tuanito/2-wheel-balanced-bot/site/files/descend_step-100-fail.jpg

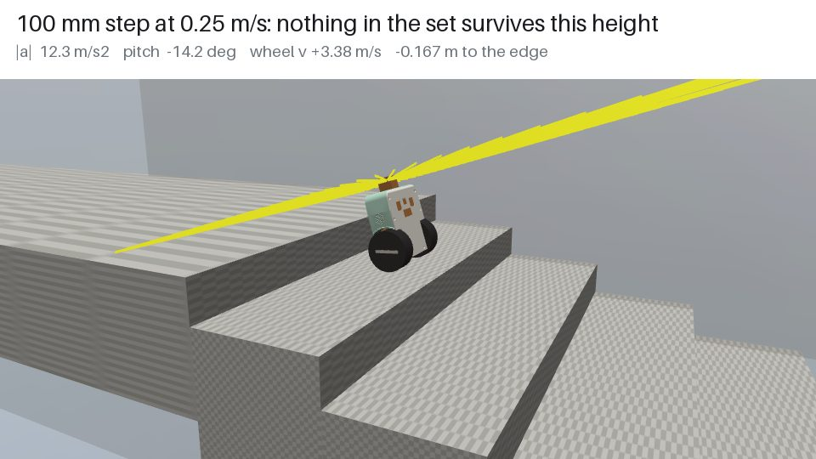
site/files/descend_step-100-fail.jpg
