tuanito/2-wheel-balanced-bot/site/files/descend_step-060-ok.jpg

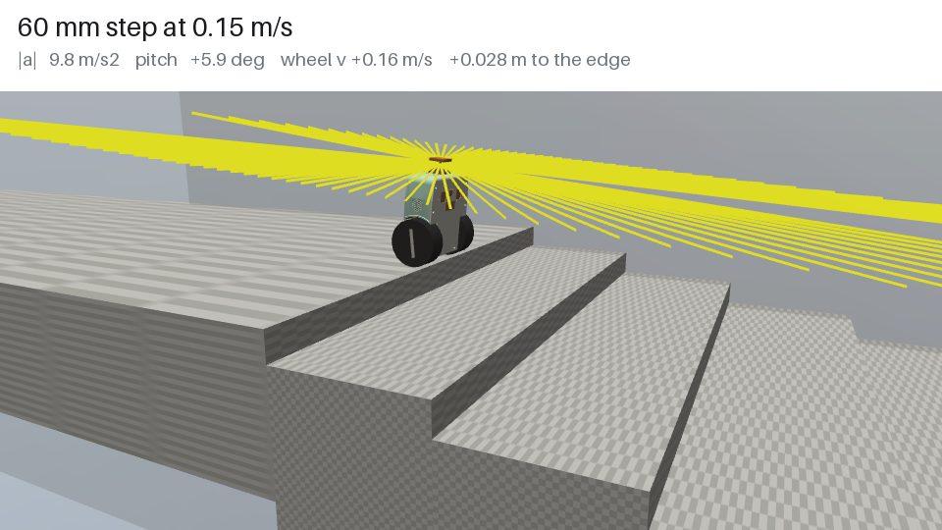
site/files/descend_step-060-ok.jpg
