tuanito/2-wheel-balanced-bot/site/files/descend_catch-100.jpg

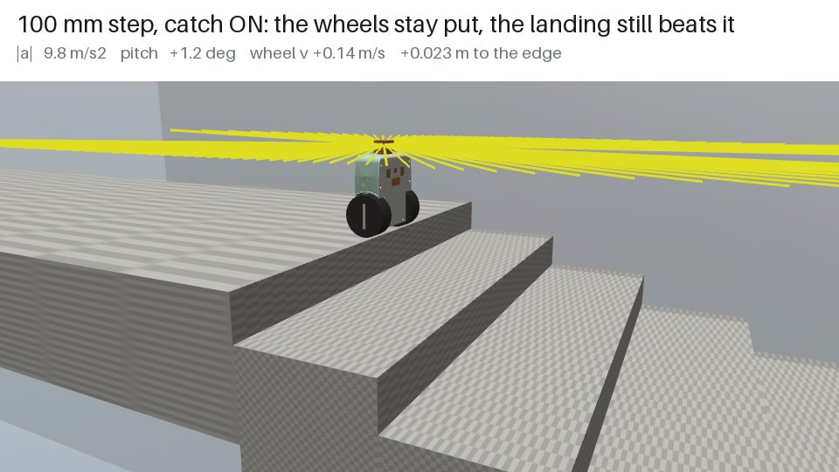
site/files/descend_catch-100.jpg
