tuanito/2-wheel-balanced-bot/site/files/descend_nocatch-040.jpg

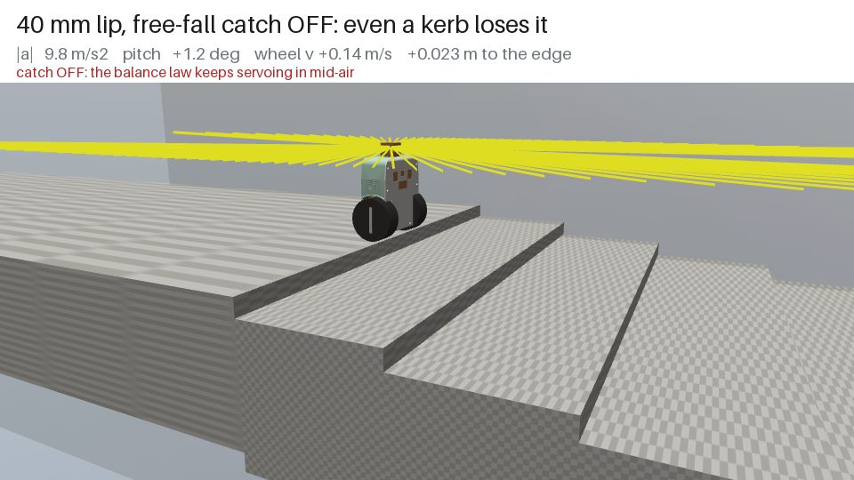
site/files/descend_nocatch-040.jpg
