tuanito/2-wheel-balanced-bot/site/files/descend_nocatch-100.jpg

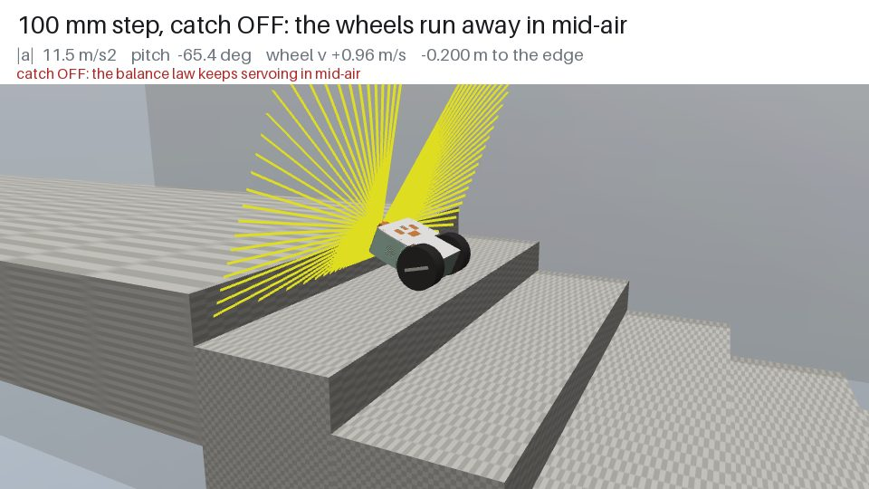
site/files/descend_nocatch-100.jpg
