tuanito/2-wheel-balanced-bot/site/files/flight_flight-060.jpg

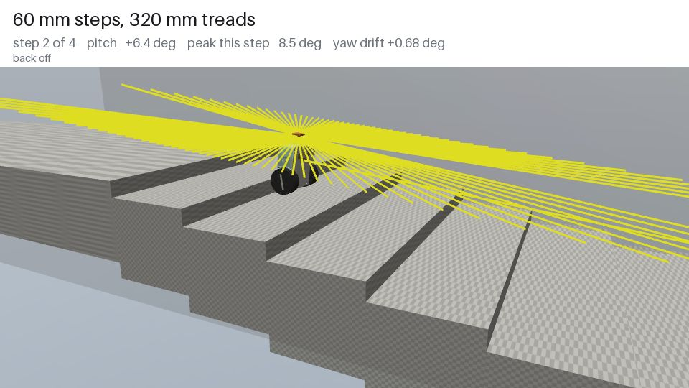
site/files/flight_flight-060.jpg
