tuanito/2-wheel-balanced-bot/site/files/flight_flight-150.jpg

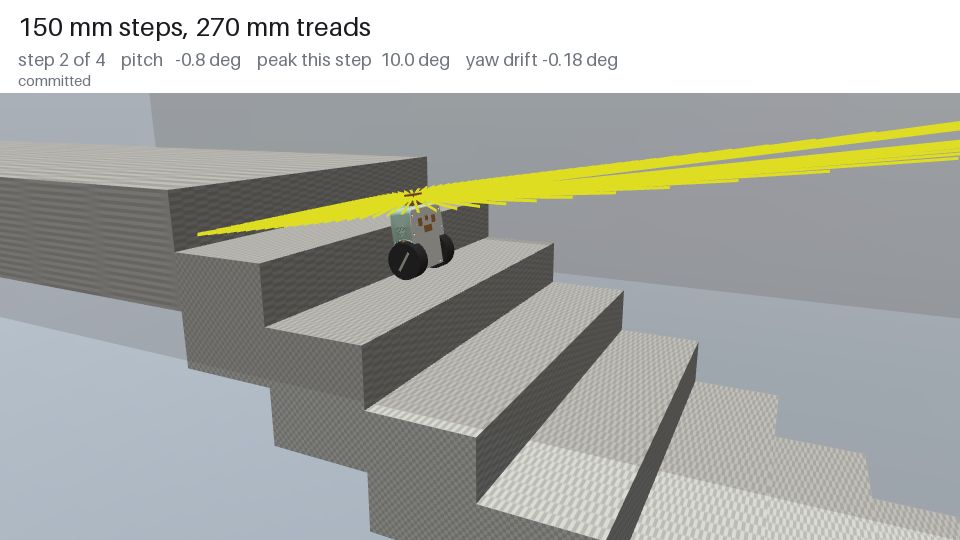
site/files/flight_flight-150.jpg
