tuanito/2-wheel-balanced-bot/site/files/flight_flight-170.jpg

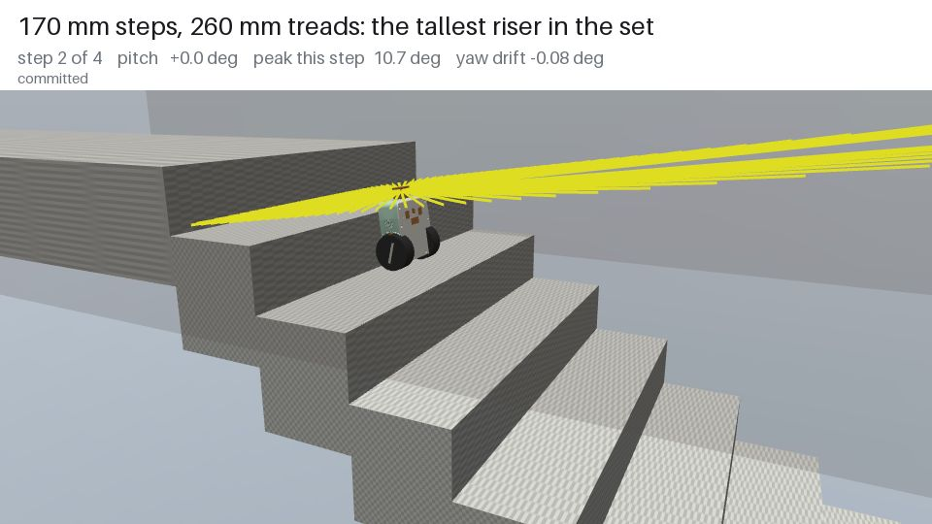
site/files/flight_flight-170.jpg
