tuanito/2-wheel-balanced-bot/site/files/stairs_ab00.jpg

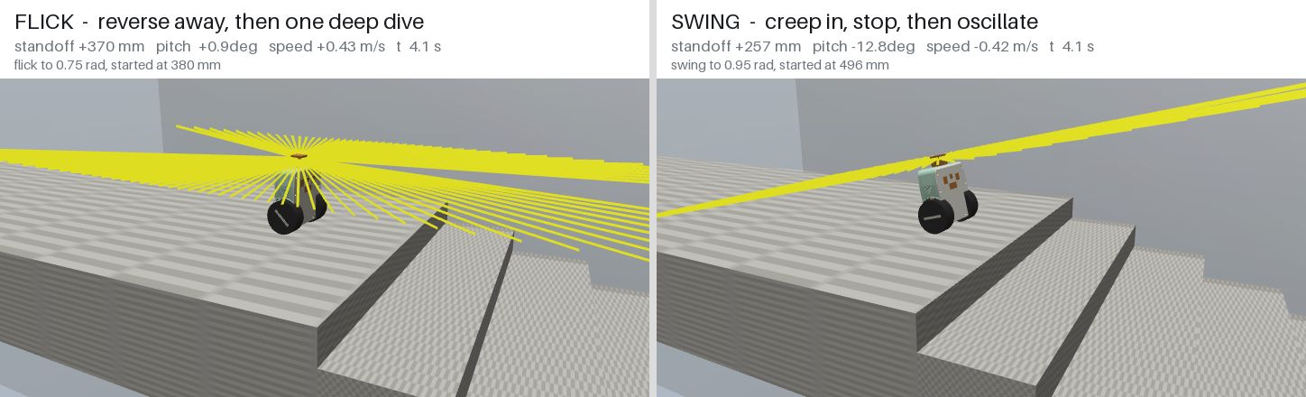
site/files/stairs_ab00.jpg
