tuanito/2-wheel-balanced-bot/site/files/stairs_ab01.jpg

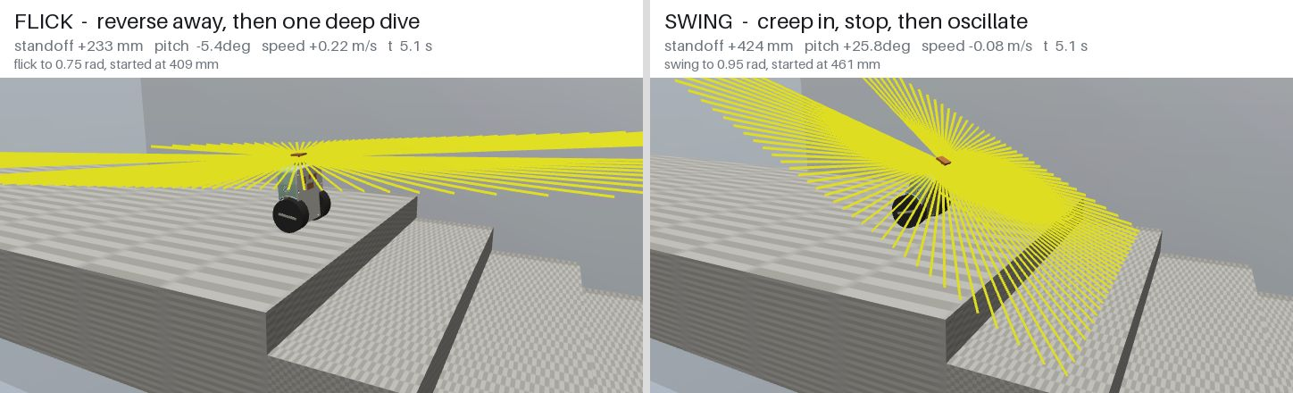
site/files/stairs_ab01.jpg
