tuanito/2-wheel-balanced-bot/site/files/stairs_ab02.jpg

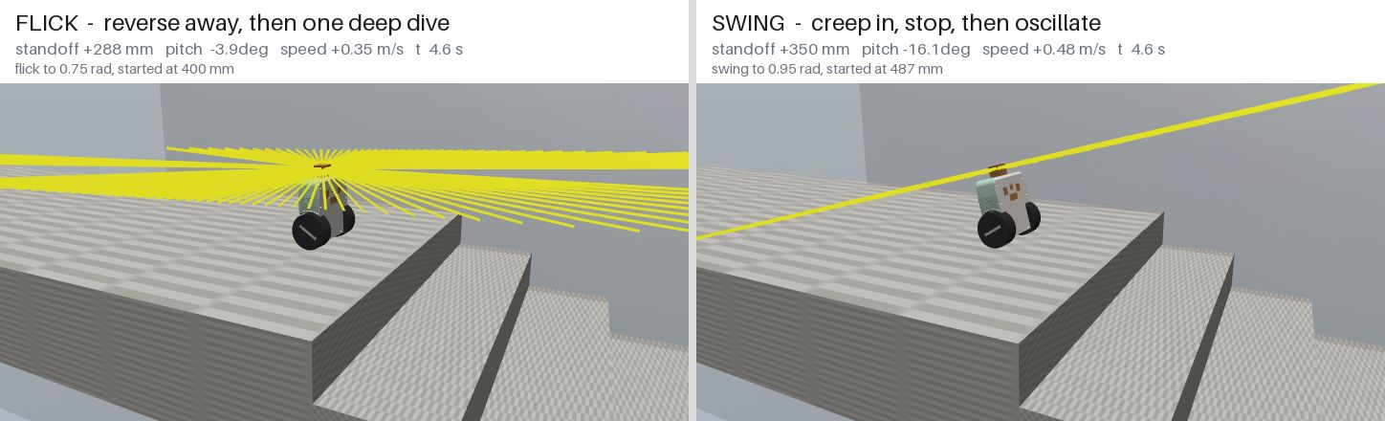
site/files/stairs_ab02.jpg
