tuanito/2-wheel-balanced-bot/site/files/stairs_ab04.jpg

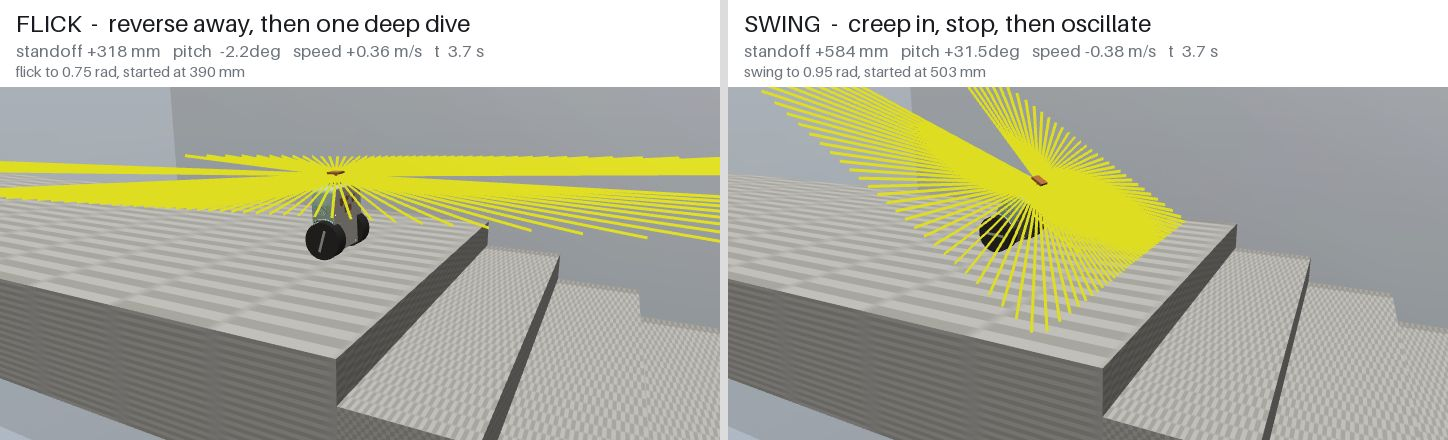
site/files/stairs_ab04.jpg
