tuanito/2-wheel-balanced-bot/site/files/stairs_ab05.jpg

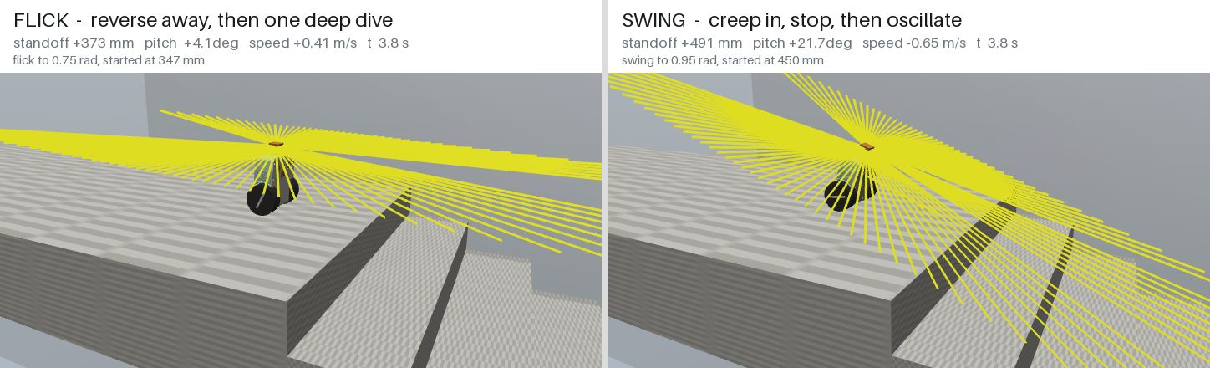
site/files/stairs_ab05.jpg
