tuanito/2-wheel-balanced-bot/site/files/stairs_ab06.jpg

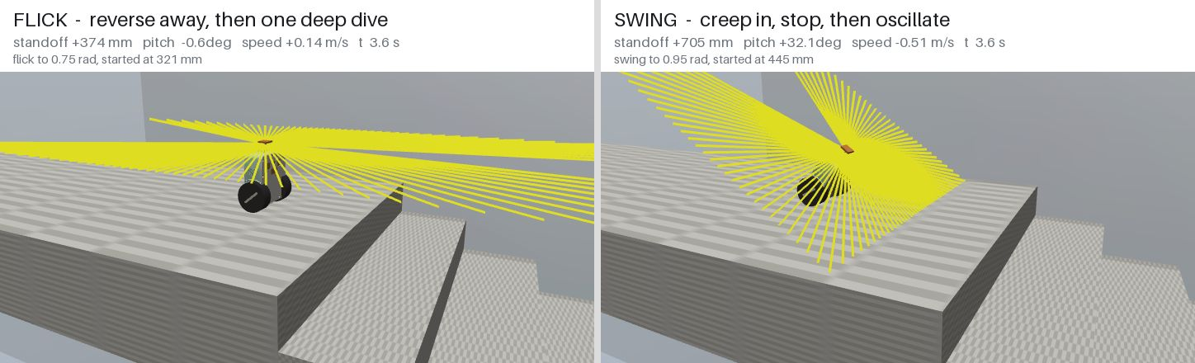
site/files/stairs_ab06.jpg
