tuanito/2-wheel-balanced-bot/site/files/stairs_ab07.jpg

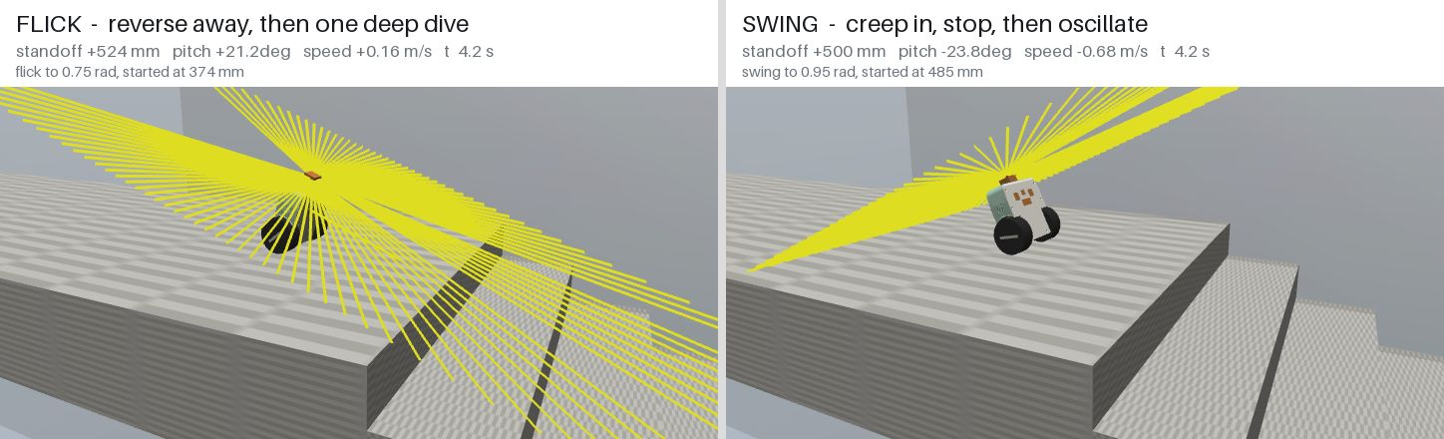
site/files/stairs_ab07.jpg
