tuanito/2-wheel-balanced-bot/site/files/stairs_ab08.jpg

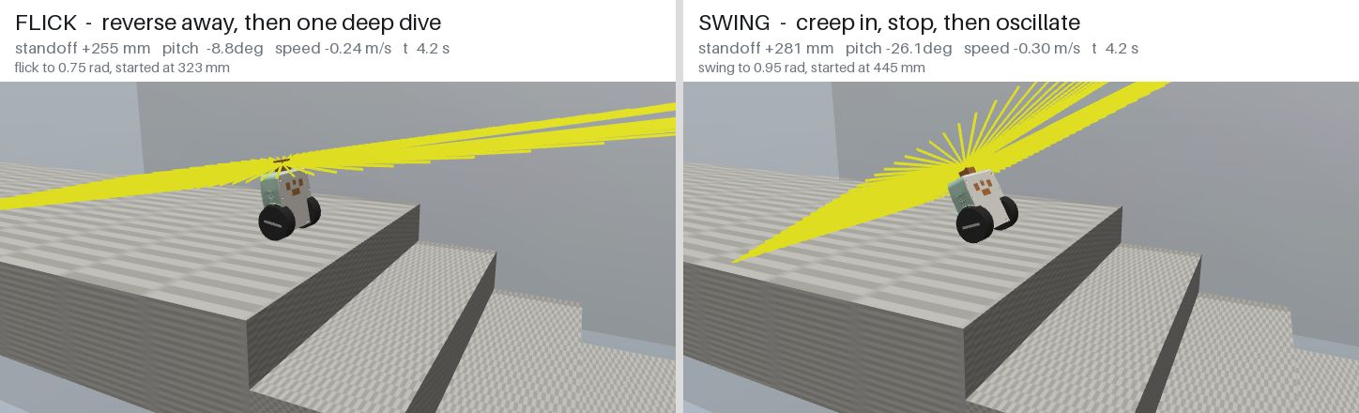
site/files/stairs_ab08.jpg
