tuanito/2-wheel-balanced-bot/site/files/stairs_ab09.jpg

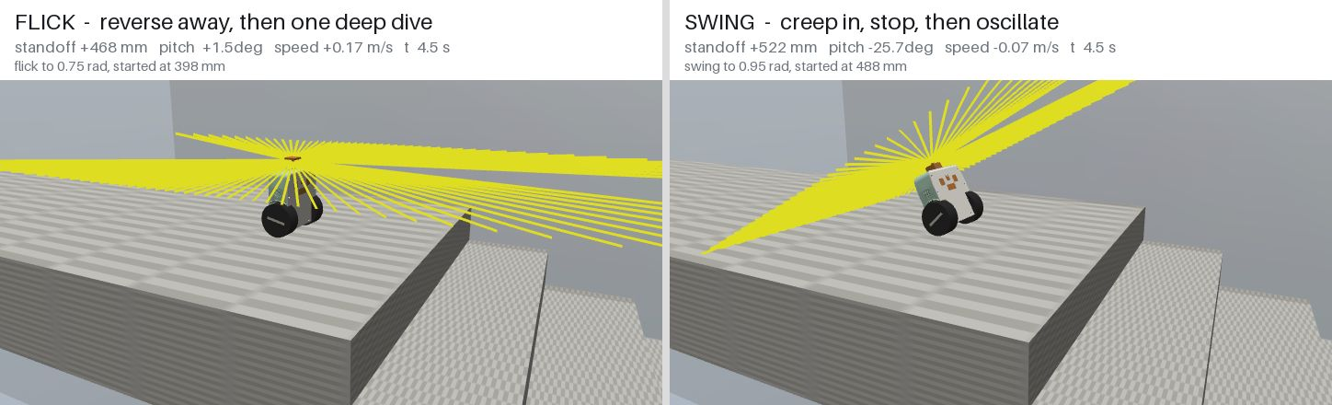
site/files/stairs_ab09.jpg
