tuanito/2-wheel-balanced-bot/site/files/stairs_narrow-tread.jpg

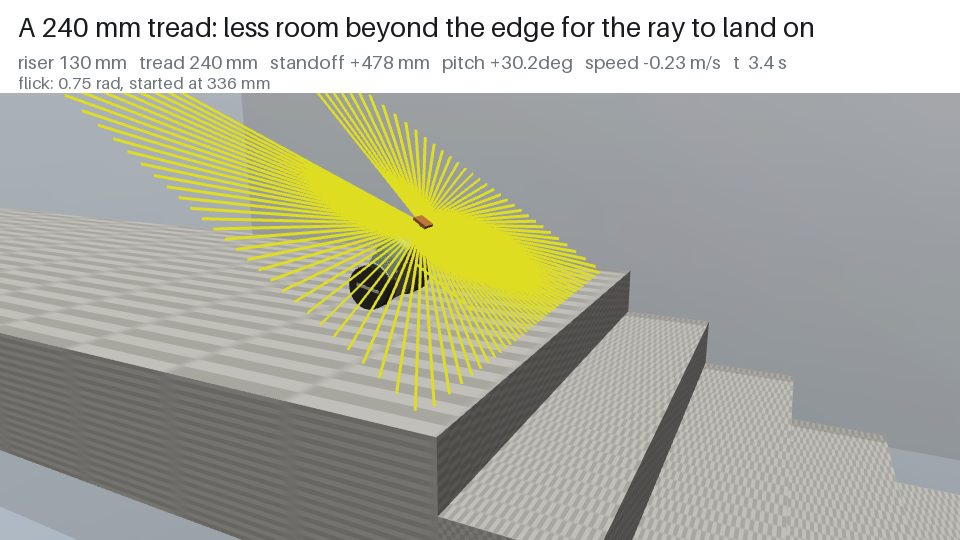
site/files/stairs_narrow-tread.jpg
