tuanito/2-wheel-balanced-bot/site/files/stairs_rolling-in.jpg

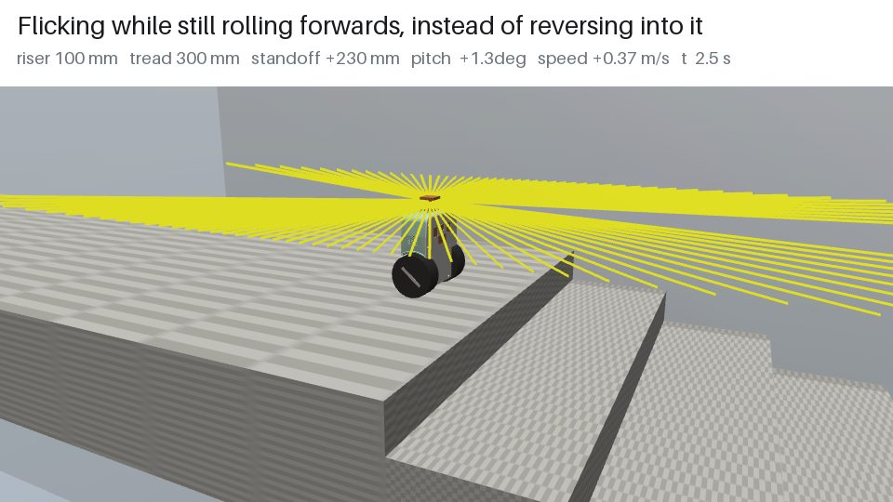
site/files/stairs_rolling-in.jpg
