tuanito/2-wheel-balanced-bot/site/files/stairs_swing-150.jpg

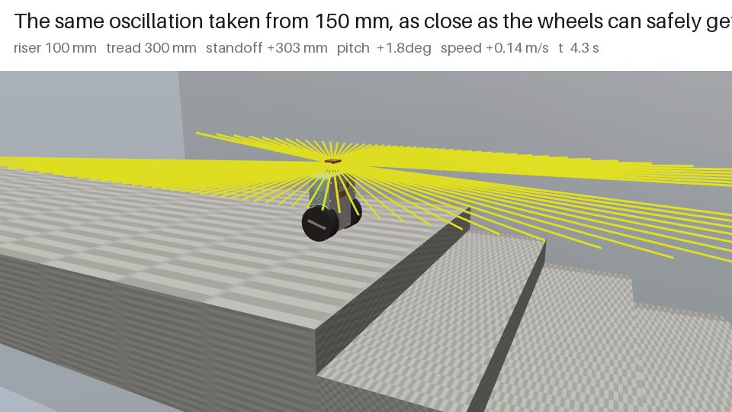
site/files/stairs_swing-150.jpg
