tuanito/2-wheel-balanced-bot/site/files/stairs_swing-480.jpg

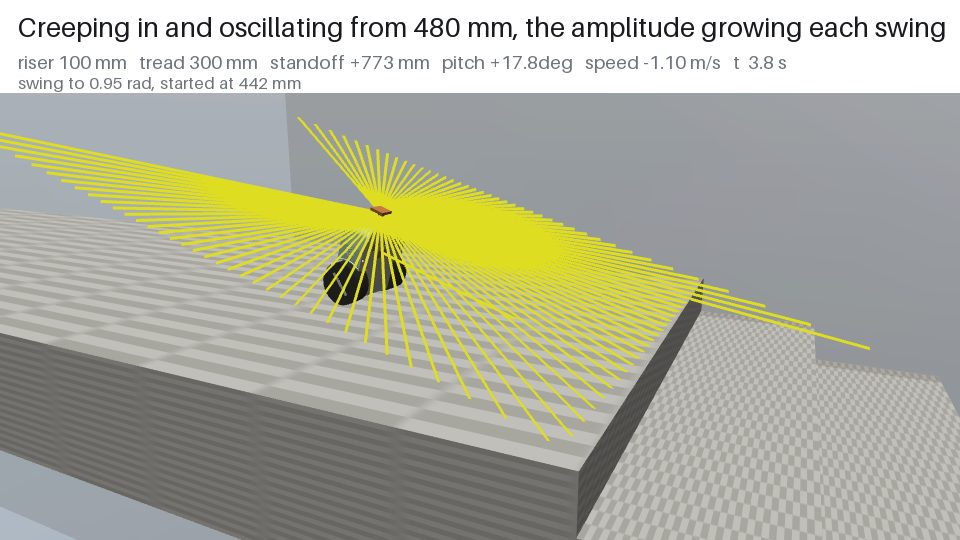
site/files/stairs_swing-480.jpg
