tuanito/2-wheel-balanced-bot/site/files/stairs_tall-170.jpg

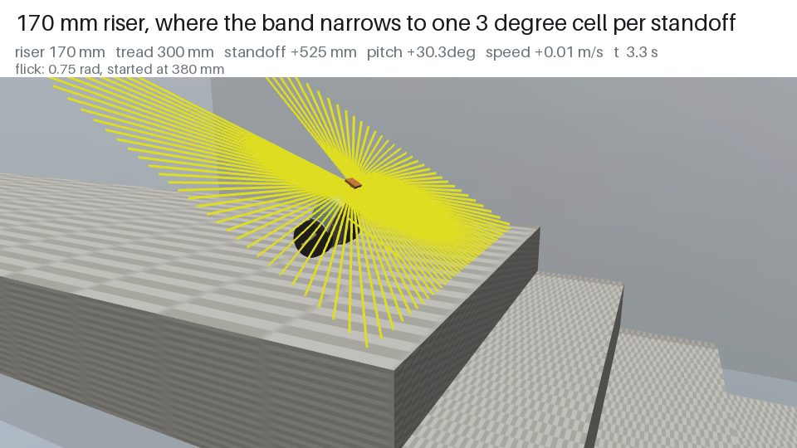
site/files/stairs_tall-170.jpg
