tuanito/2-wheel-balanced-bot/site/files/stairs_too-deep.jpg

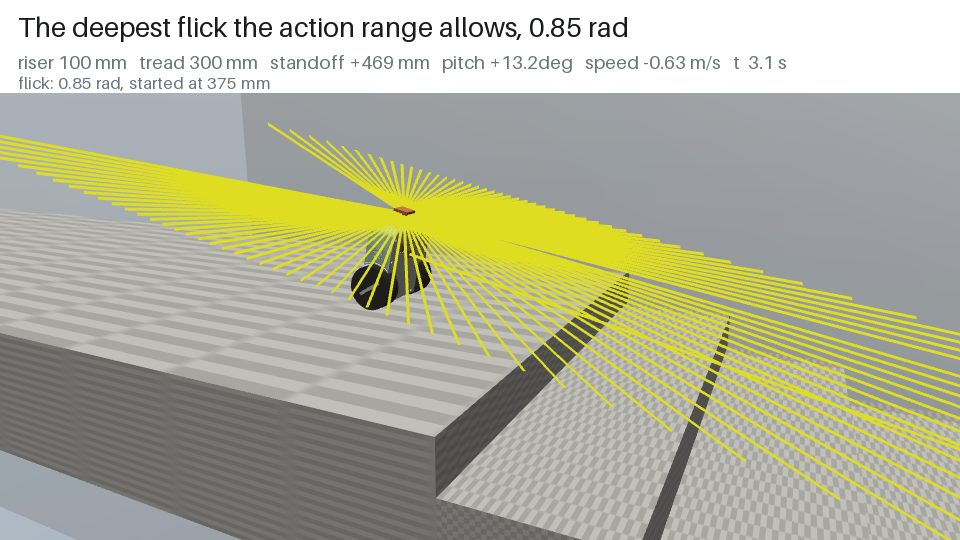
site/files/stairs_too-deep.jpg
