tuanito/2-wheel-balanced-bot/site/files/stairs_too-far.jpg

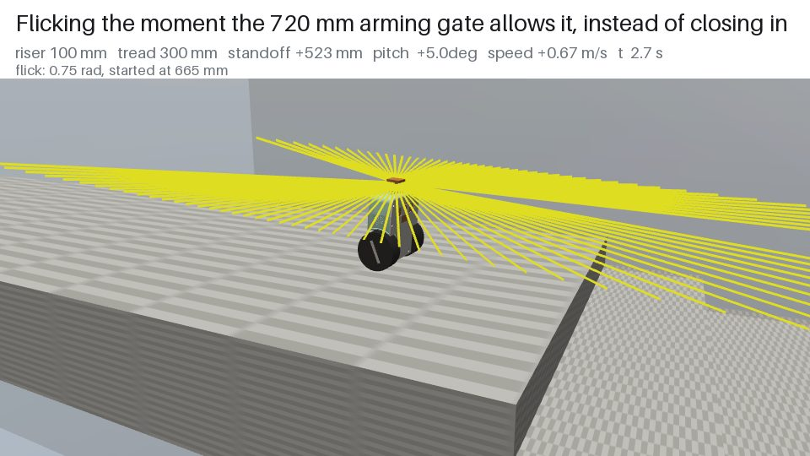
site/files/stairs_too-far.jpg
