tuanito/2-wheel-balanced-bot/site/files/stairs_too-shallow.jpg

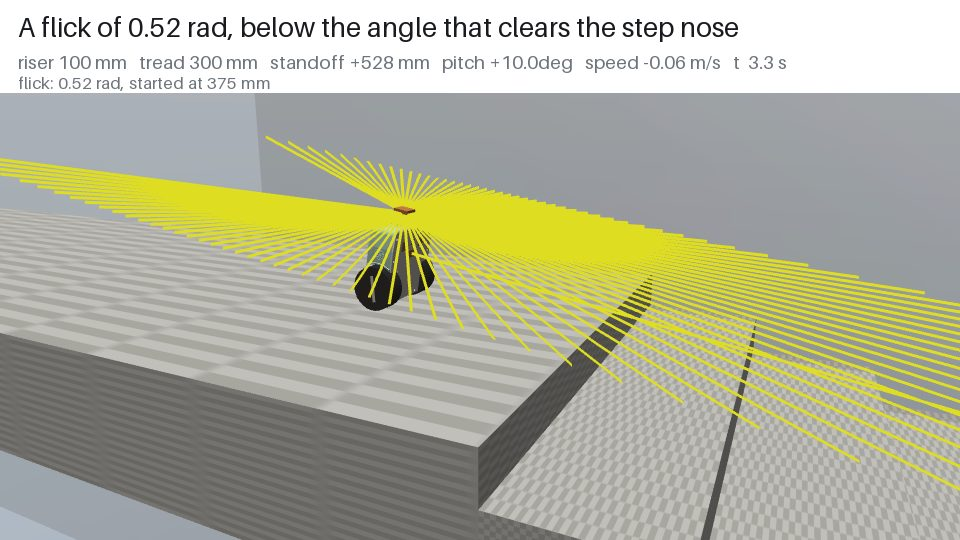
site/files/stairs_too-shallow.jpg
