tuanito/2-wheel-balanced-bot/site/files/stairs_works-080.jpg

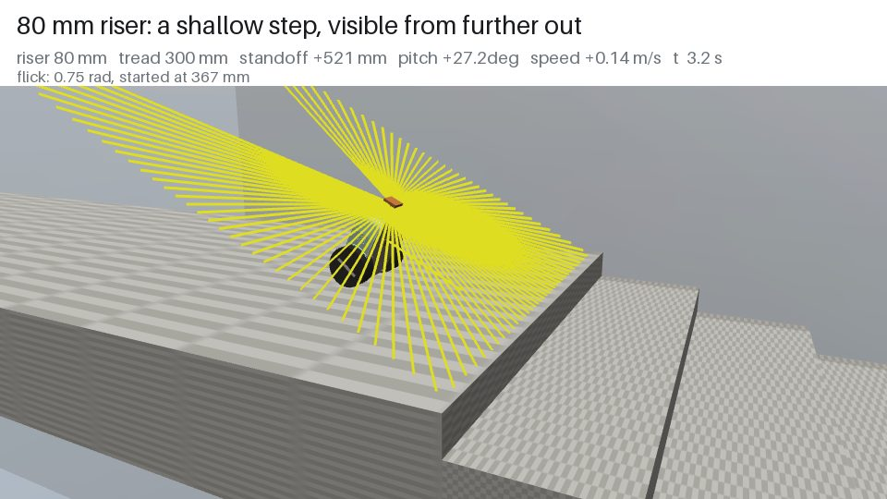
site/files/stairs_works-080.jpg
