tuanito/2-wheel-balanced-bot/site/files/stairs_works-100.jpg

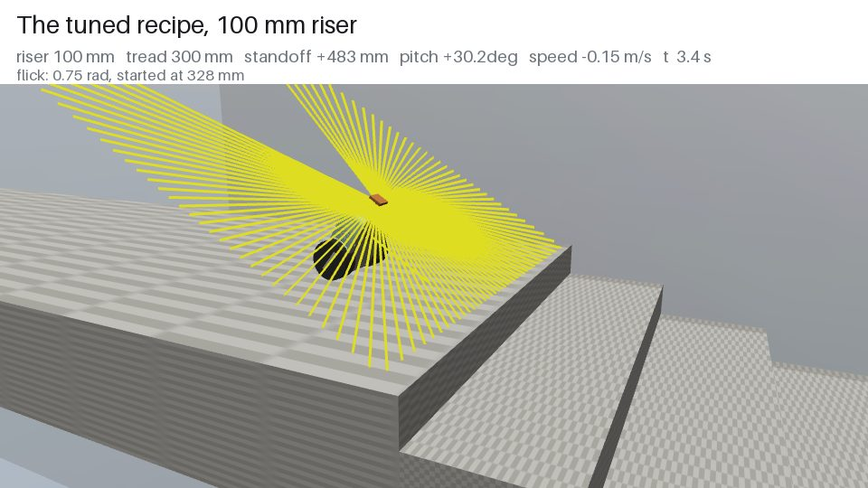
site/files/stairs_works-100.jpg
