tuanito/2-wheel-balanced-bot/site/files/stairs_works-130.jpg

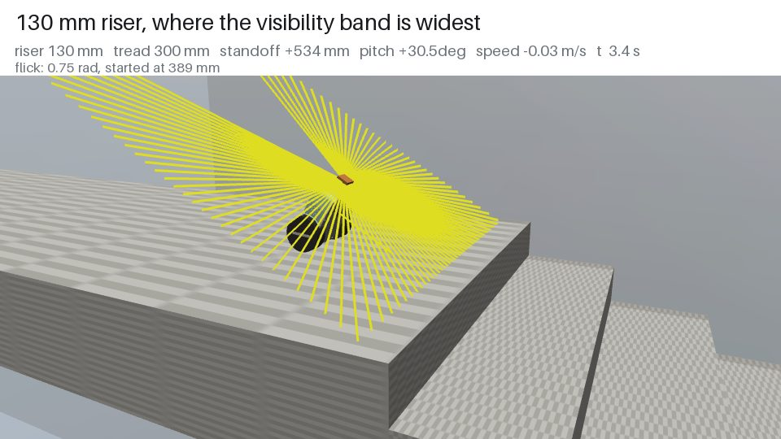
site/files/stairs_works-130.jpg
