tuanito/2-wheel-balanced-bot/site/files/stairs_works-150.jpg

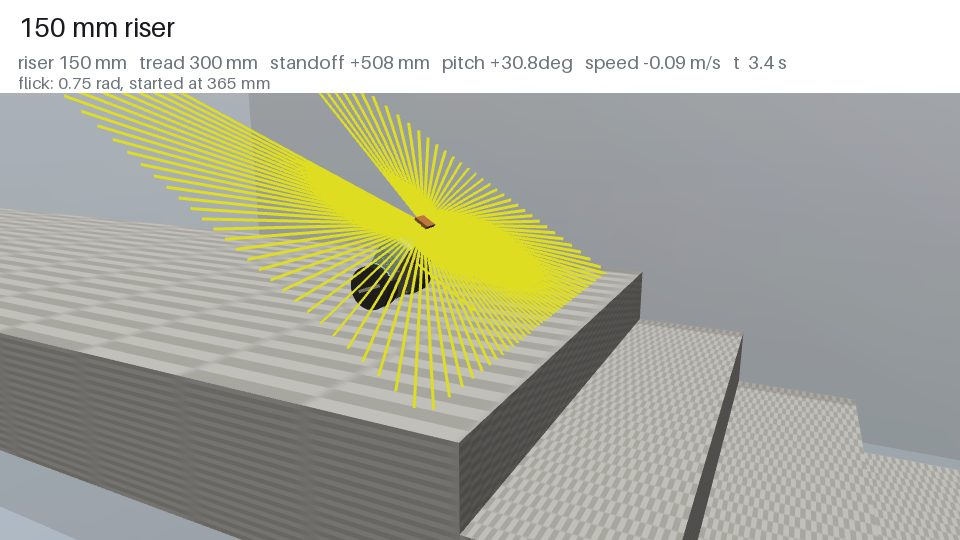
site/files/stairs_works-150.jpg
