tuanito/2-wheel-balanced-bot/site/files/v11/contact_plate.png

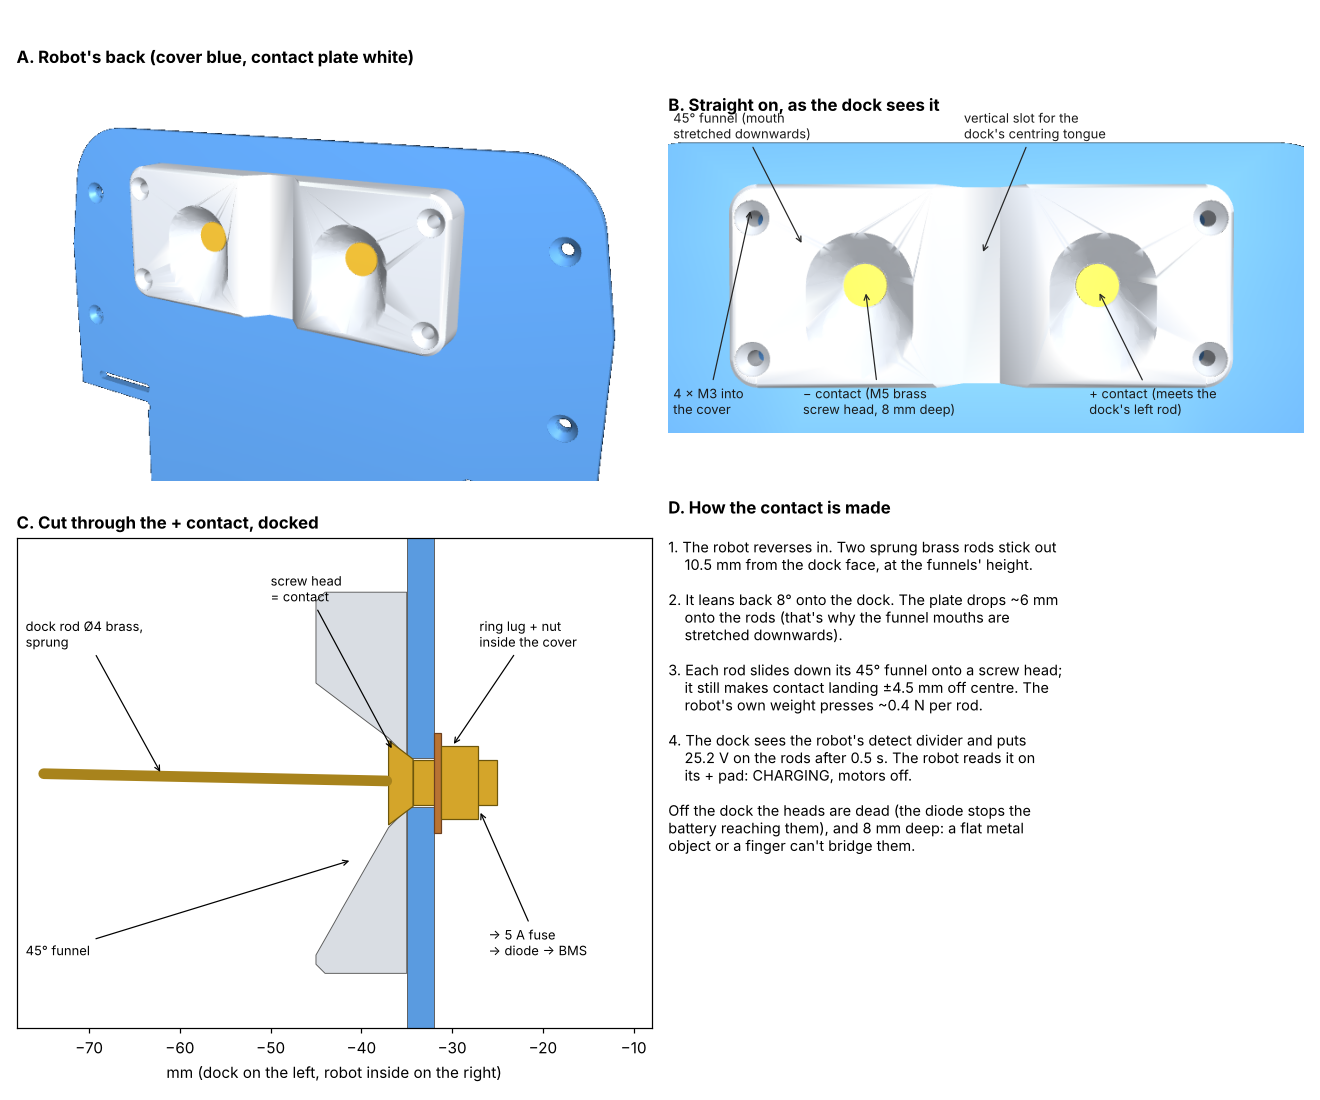
site/files/v11/contact_plate.png
