tuanito/2-wheel-balanced-bot/site/files/v11/dock_5starts.png

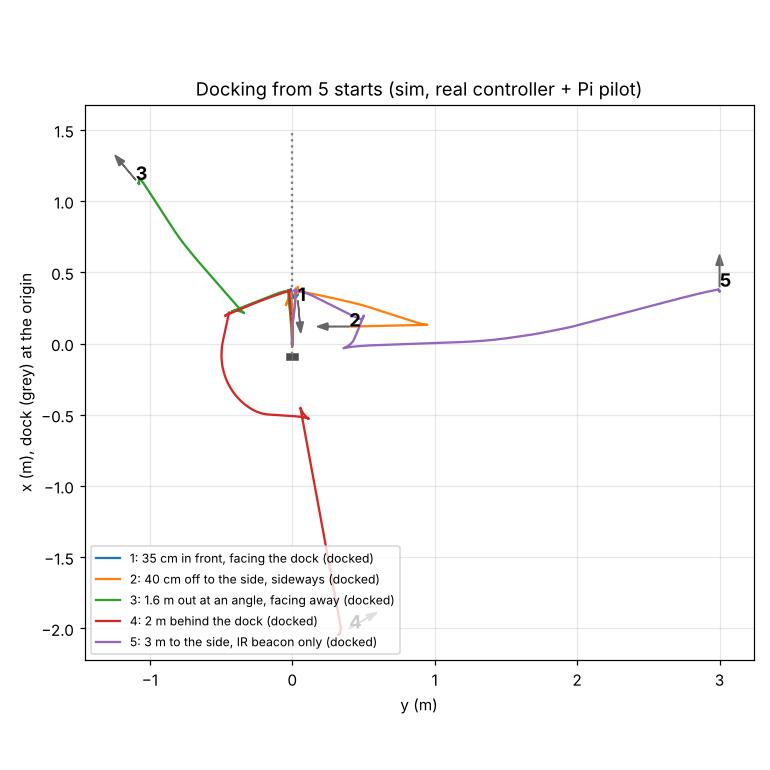
site/files/v11/dock_5starts.png
