tuanito/2-wheel-balanced-bot/site/files/v11/dock_sweep.png

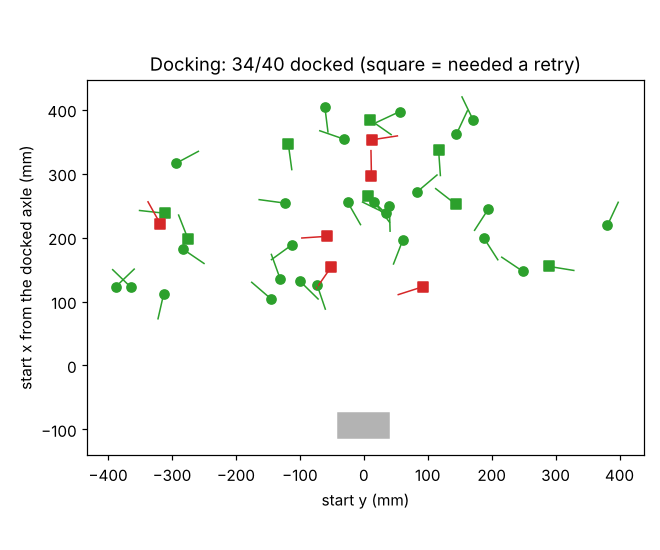
site/files/v11/dock_sweep.png
