tuanito/2-wheel-balanced-bot/site/files/v11/fea_before_after.png

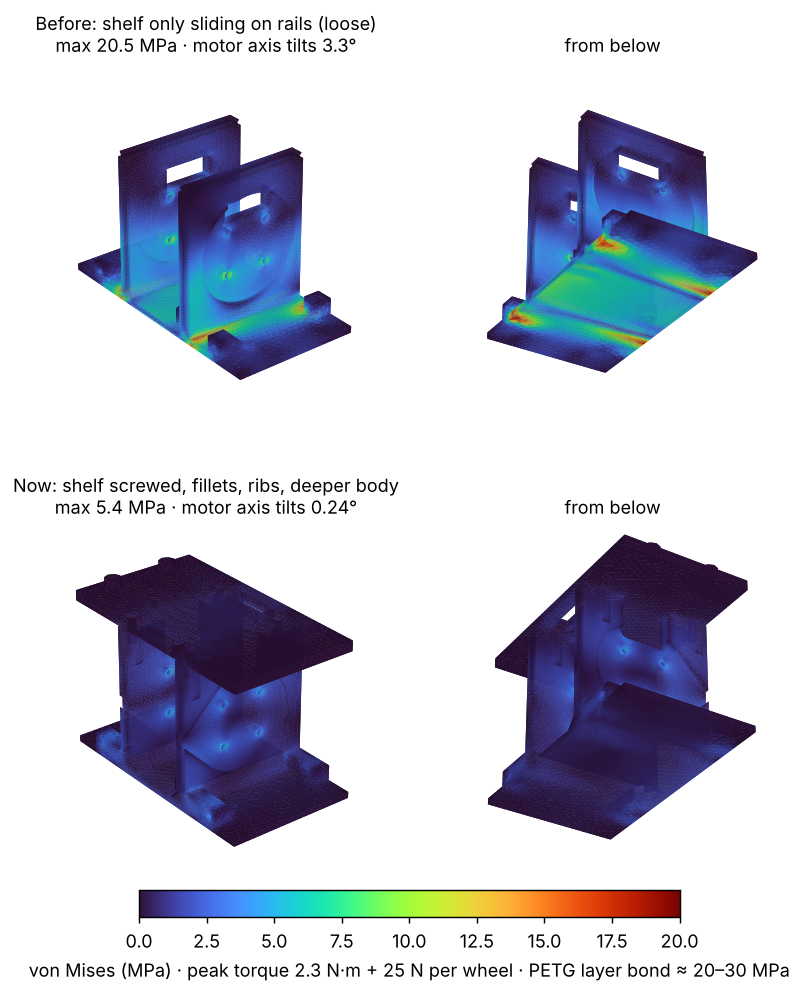
site/files/v11/fea_before_after.png
