tuanito/2-wheel-balanced-bot/site/files/v11/home_sweep.png

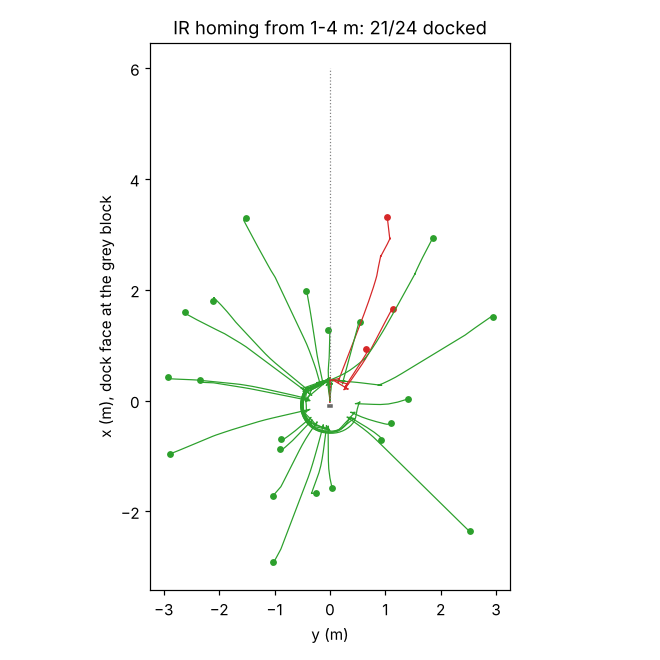
site/files/v11/home_sweep.png
