tuanito/2-wheel-balanced-bot/site/files/v11/standup_mf7015_1-facedown.jpg

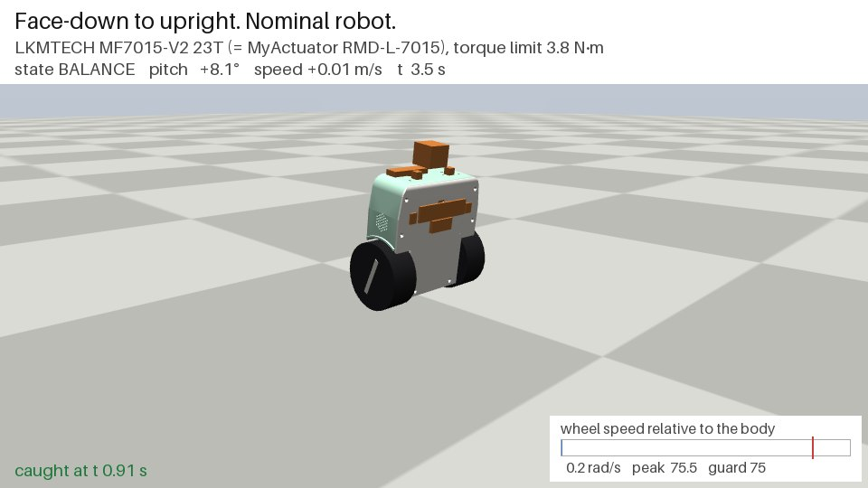
site/files/v11/standup_mf7015_1-facedown.jpg
