tuanito/2-wheel-balanced-bot/site/files/v11/standup_mf7015_2-backdown.jpg

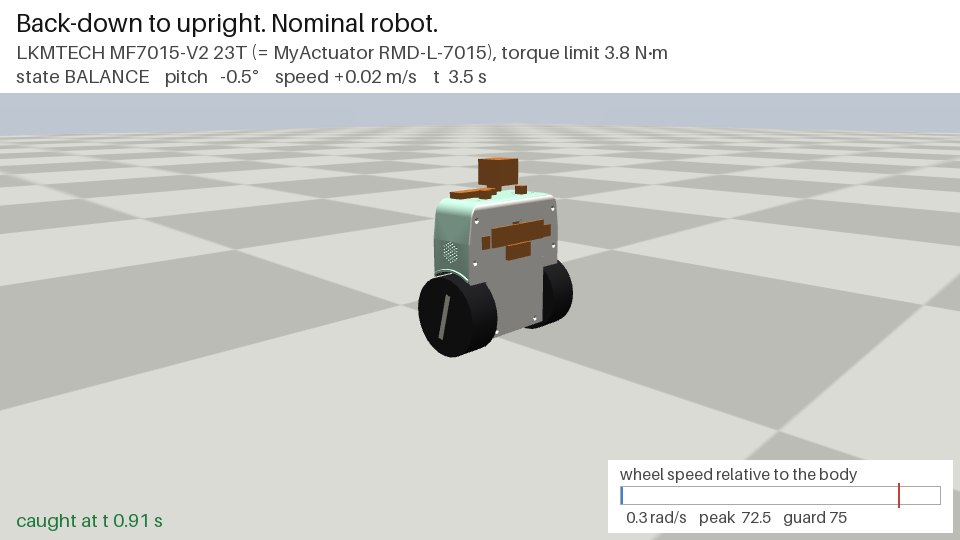
site/files/v11/standup_mf7015_2-backdown.jpg
