tuanito/2-wheel-balanced-bot/site/files/v11/standup_mf7015_3-facedown-delay2.jpg

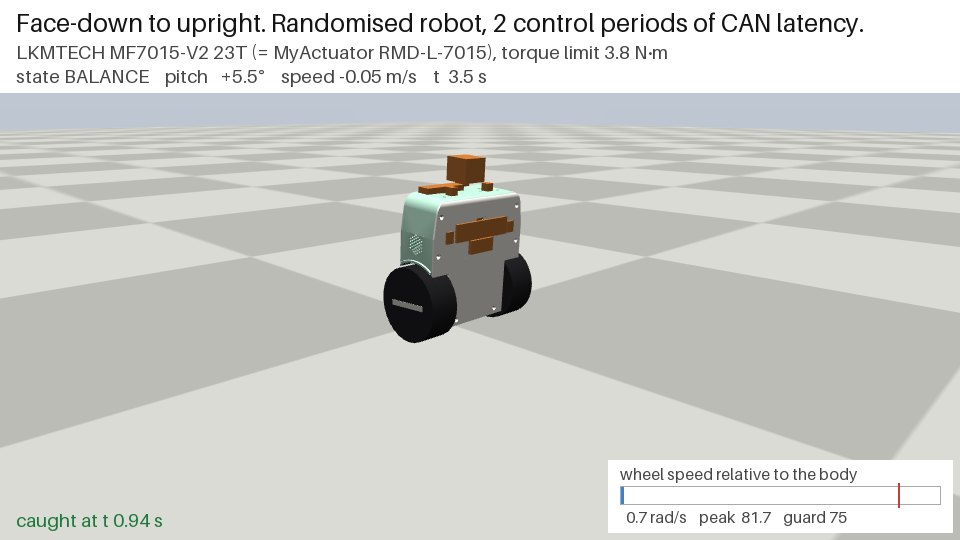
site/files/v11/standup_mf7015_3-facedown-delay2.jpg
