tuanito/2-wheel-balanced-bot/site/files/v11/standup_mf7015_4-backdown-random.jpg

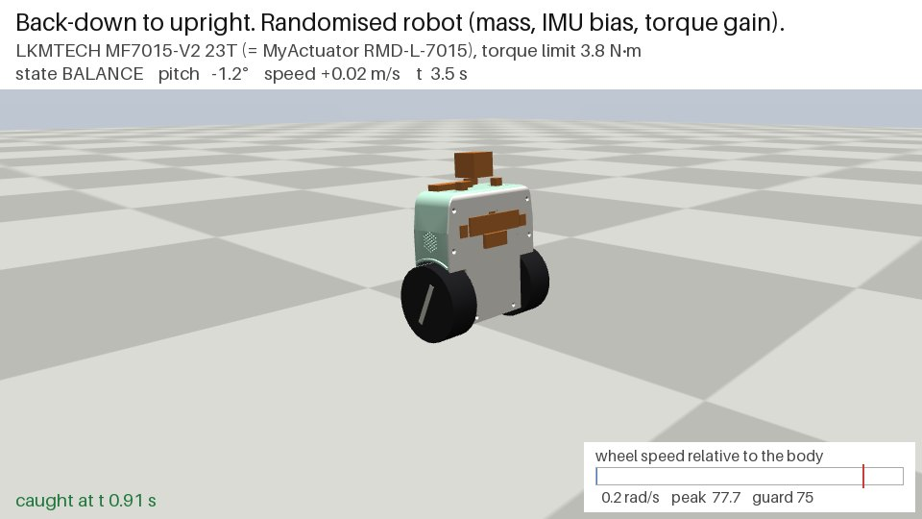
site/files/v11/standup_mf7015_4-backdown-random.jpg
