tuanito/2-wheel-balanced-bot/site/files/v11/standup_mf7015_5-knocked-over.jpg

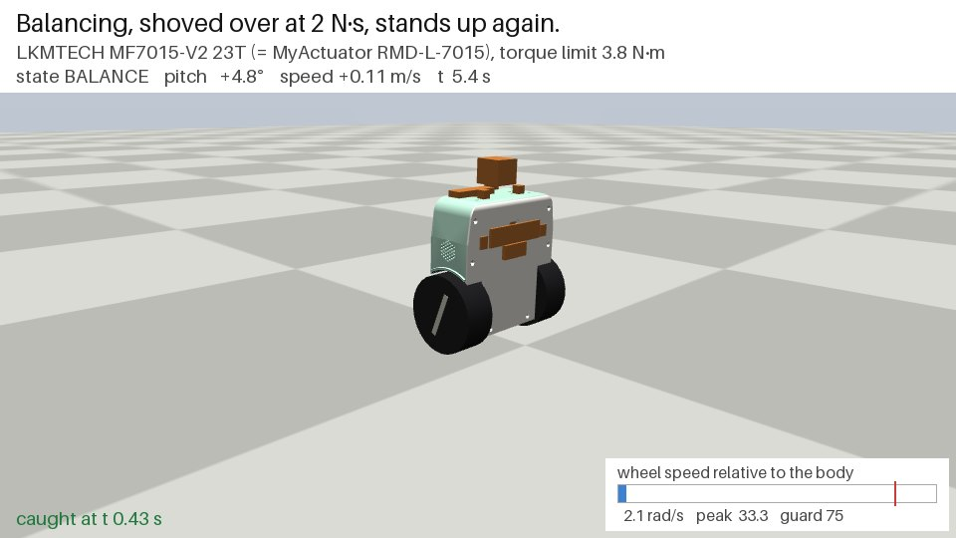
site/files/v11/standup_mf7015_5-knocked-over.jpg
