tuanito/2-wheel-balanced-bot/cad/robot_assembly.step

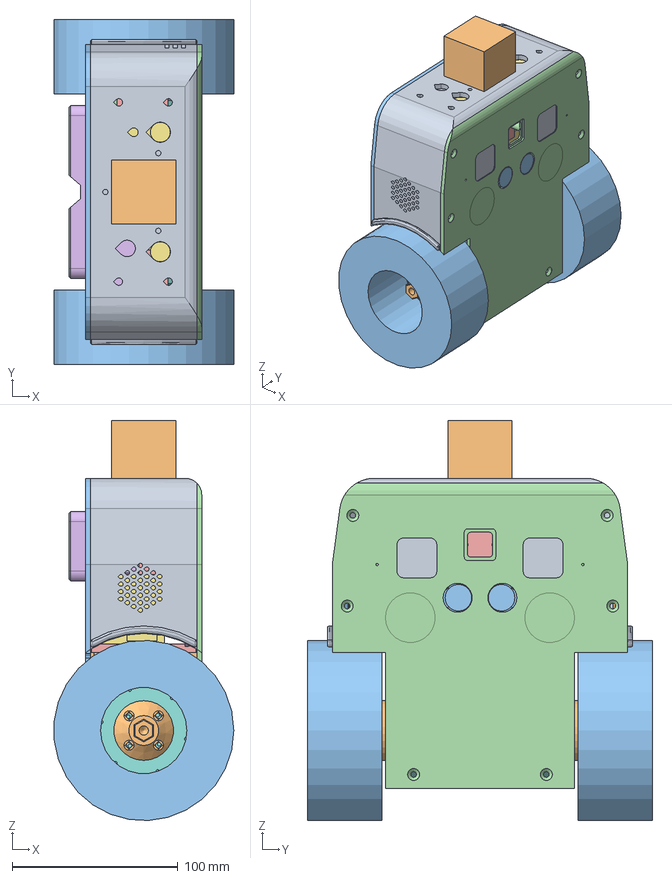
[picture p43: CAD file, 2026-11-09]
cad/robot_assembly.step
108.3 x 208.0 x 241.0 mm
