tuanito/2-wheel-balanced-bot/cad/robot_speaker_ring.step

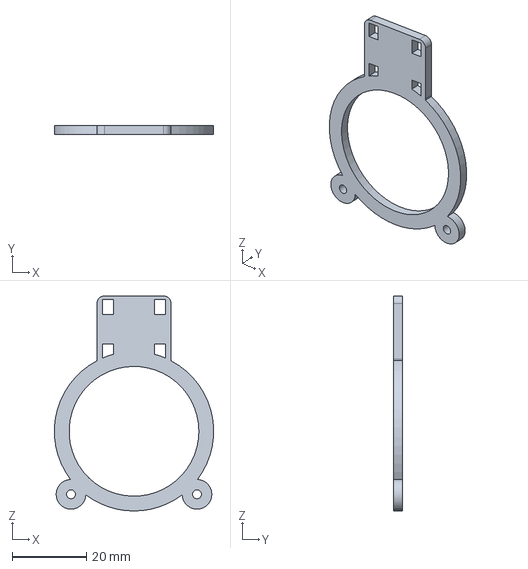
[picture p44: CAD file, 2026-11-09]
cad/robot_speaker_ring.step
43.0 x 2.50 x 58.0 mm
