tuanito/2-wheel-balanced-bot/sim/meshes/plate_l.stl

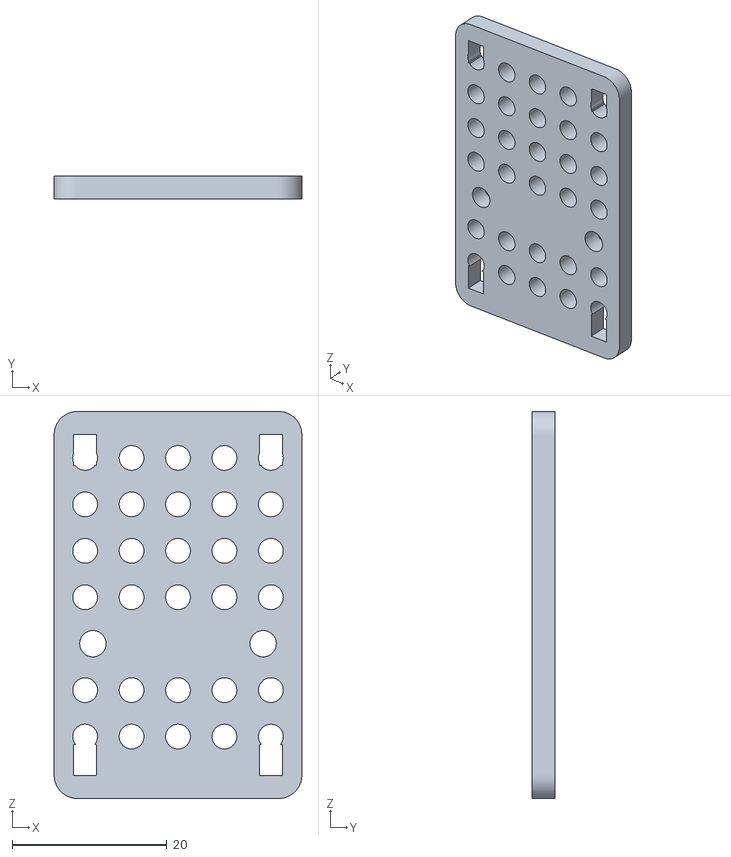
[picture p45: CAD file, 2026-11-09]
sim/meshes/plate_l.stl
32.0 x 3.00 x 50.0
