tuanito/2-wheel-balanced-bot/cad/robot_front.step

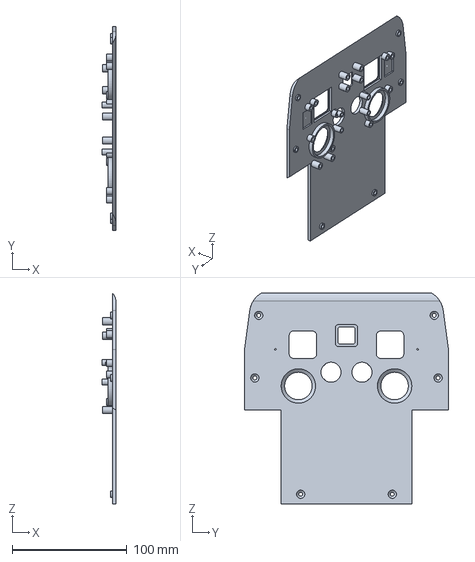
[picture p46: CAD file, 2026-11-09]
cad/robot_front.step
12.0 x 178.0 x 184.1 mm
