tuanito/2-wheel-balanced-bot/sim/meshes/ret_r.stl

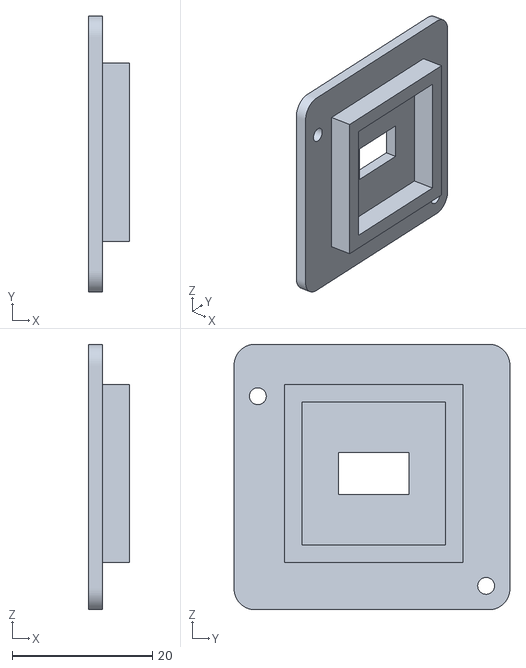
[picture p47: CAD file, 2026-11-09]
sim/meshes/ret_r.stl
5.90 x 39.3 x 37.8
