tuanito/2-wheel-balanced-bot/cad/robot_dock_head.step

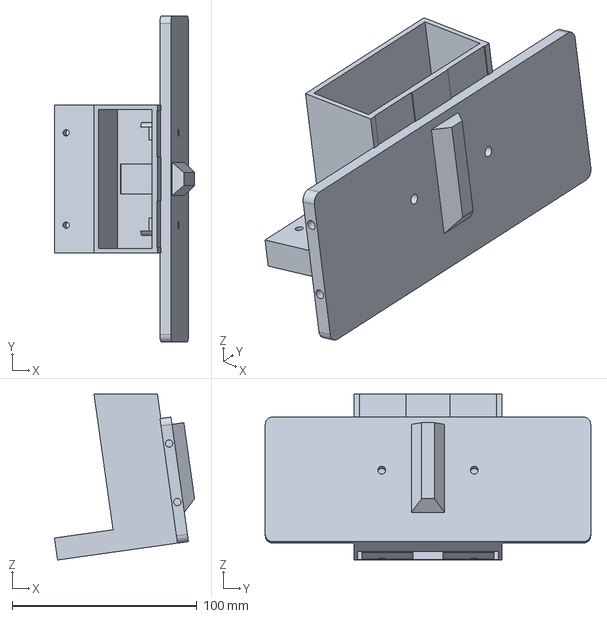
[picture p48: CAD file, 2026-11-09]
cad/robot_dock_head.step
75.8 x 176.0 x 89.8 mm
