tuanito/2-wheel-balanced-bot/sim/meshes/micc_r.stl

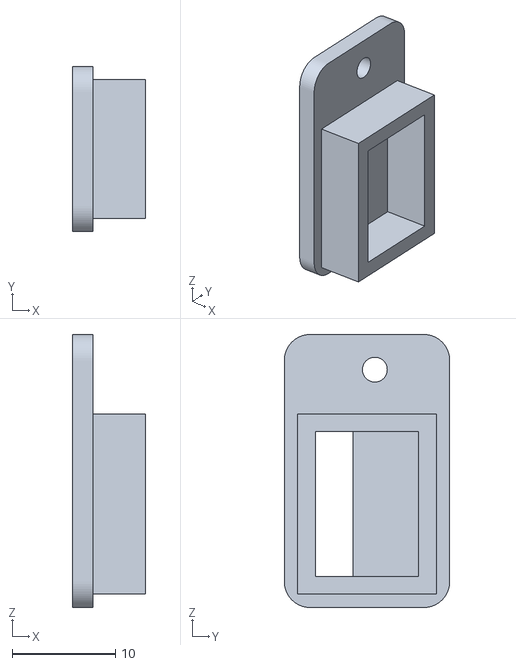
[picture p49: CAD file, 2026-11-09]
sim/meshes/micc_r.stl
7.10 x 16.0 x 26.4
