tuanito/2-wheel-balanced-bot/cad/robot_dock_foot.step

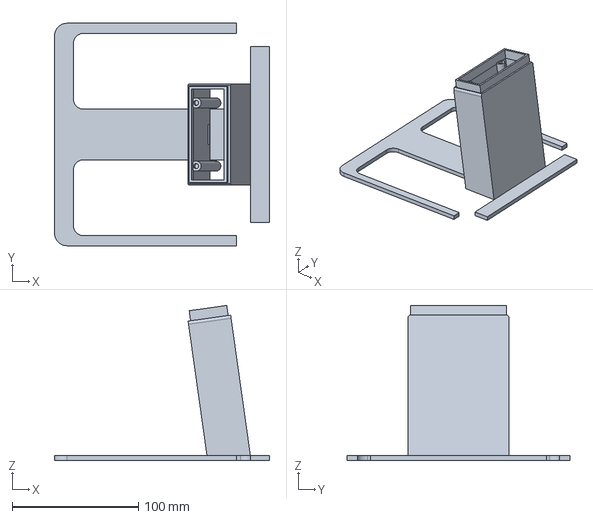
[picture p50: CAD file, 2026-11-09]
cad/robot_dock_foot.step
170.0 x 176.0 x 122.6 mm
