tuanito/2-wheel-balanced-bot/cad/mf6015_hex12_adapter.step

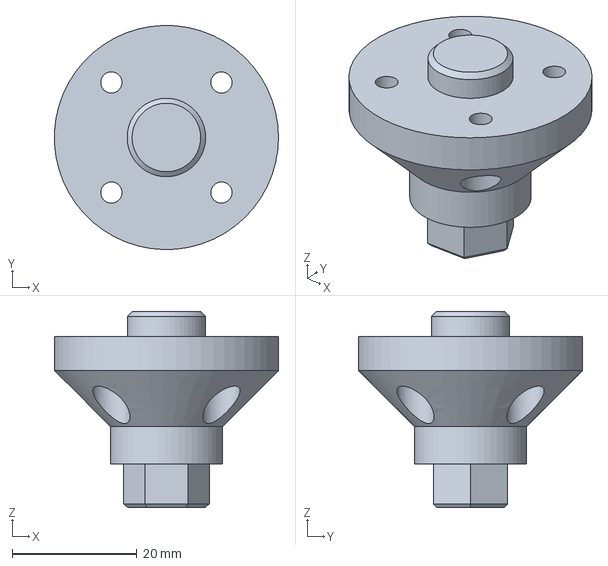
[picture p51: CAD file, 2026-11-09]
cad/mf6015_hex12_adapter.step
36.0 x 36.0 x 31.5 mm
