tuanito/2-wheel-balanced-bot/sim/meshes/cap.stl

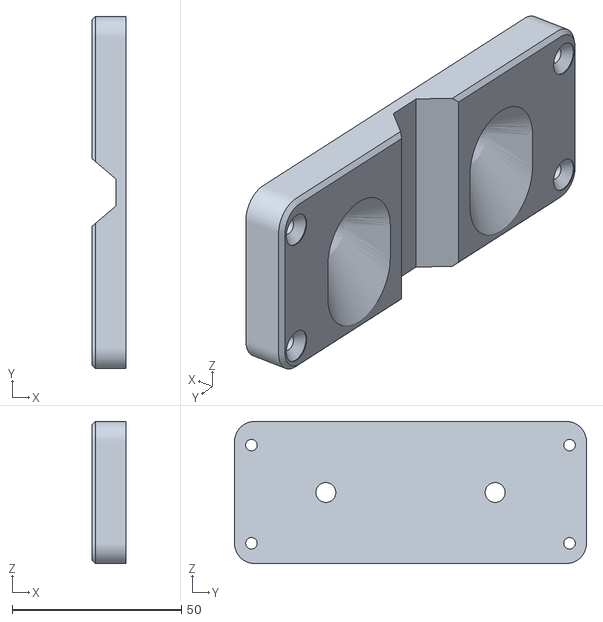
[picture p52: CAD file, 2026-11-09]
sim/meshes/cap.stl
10.0 x 104.0 x 42.0
