tuanito/2-wheel-balanced-bot/cad/robot_cover.step

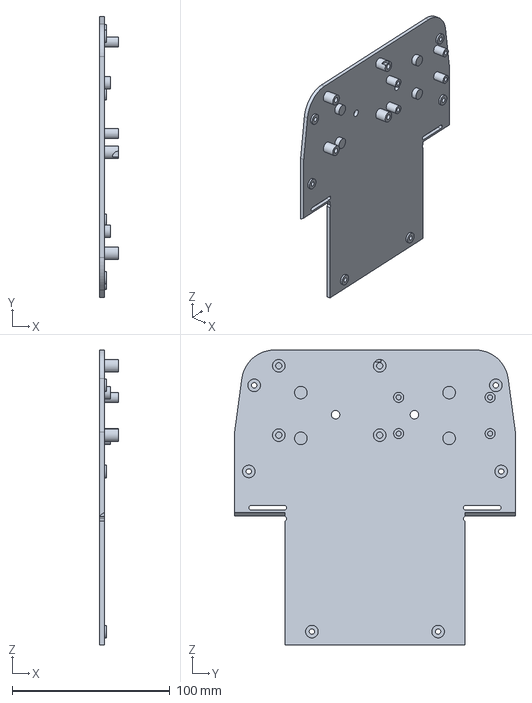
[picture p53: CAD file, 2026-11-09]
cad/robot_cover.step
12.0 x 178.0 x 187.0 mm
