tuanito/2-wheel-balanced-bot/sim/meshes/tray.stl

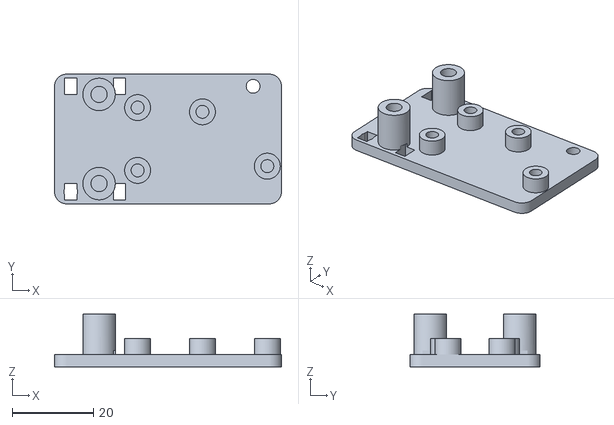
[picture p54: CAD file, 2026-11-09]
sim/meshes/tray.stl
56.0 x 32.0 x 13.0
