tuanito/2-wheel-balanced-bot/cad/robot_dock_mast.step

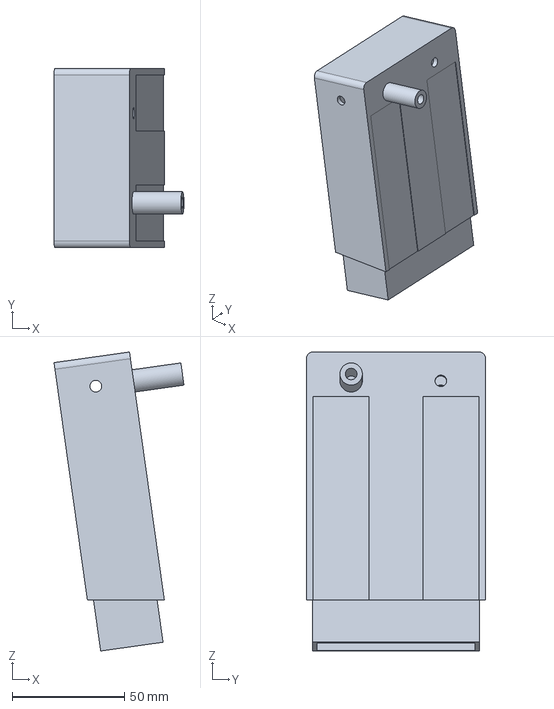
[picture p55: CAD file, 2026-11-09]
cad/robot_dock_mast.step
58.0 x 80.0 x 133.3 mm
