tuanito/2-wheel-balanced-bot/sim/meshes/body.stl

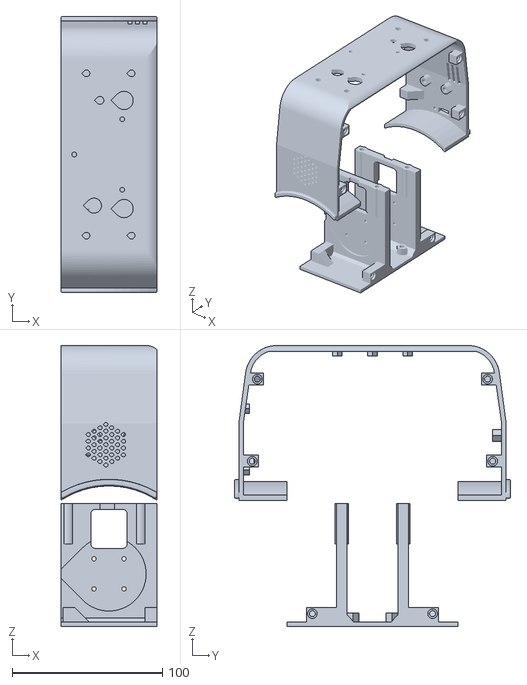
[picture p56: CAD file, 2026-11-09]
sim/meshes/body.stl
64.0 x 184.0 x 187.0
