tuanito/2-wheel-balanced-bot/cad/robot_coil_cap.step

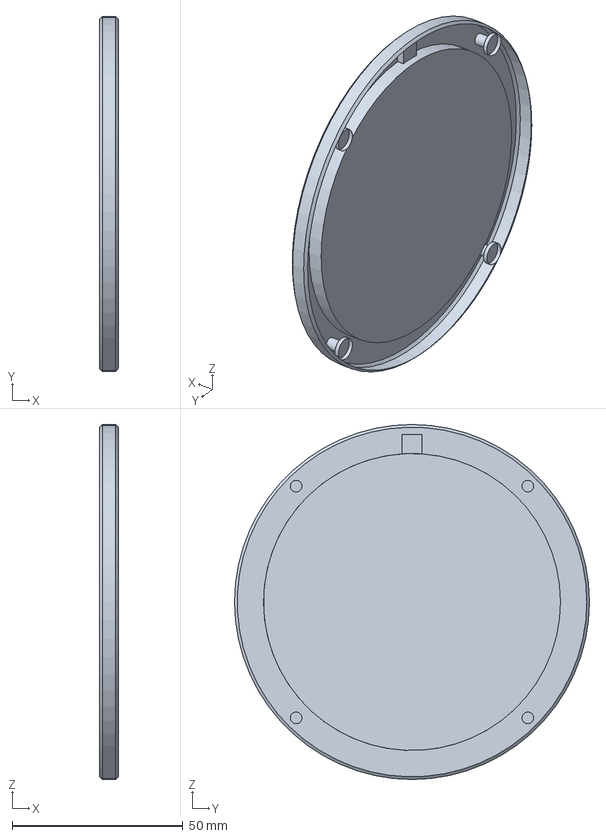
[picture p57: CAD file, 2026-11-09]
cad/robot_coil_cap.step
5.50 x 104.0 x 104.0 mm
