tuanito/2-wheel-balanced-bot/sim/meshes/lret_r.stl

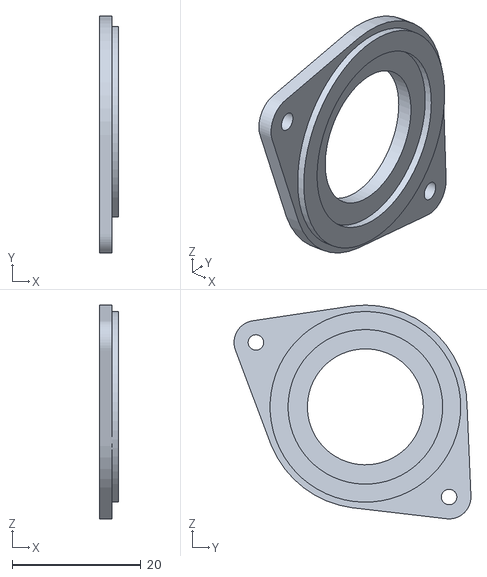
[picture p58: CAD file, 2026-11-09]
sim/meshes/lret_r.stl
3.00 x 36.8 x 33.2
