tuanito/2-wheel-balanced-bot/cad/robot_ir_hood.step

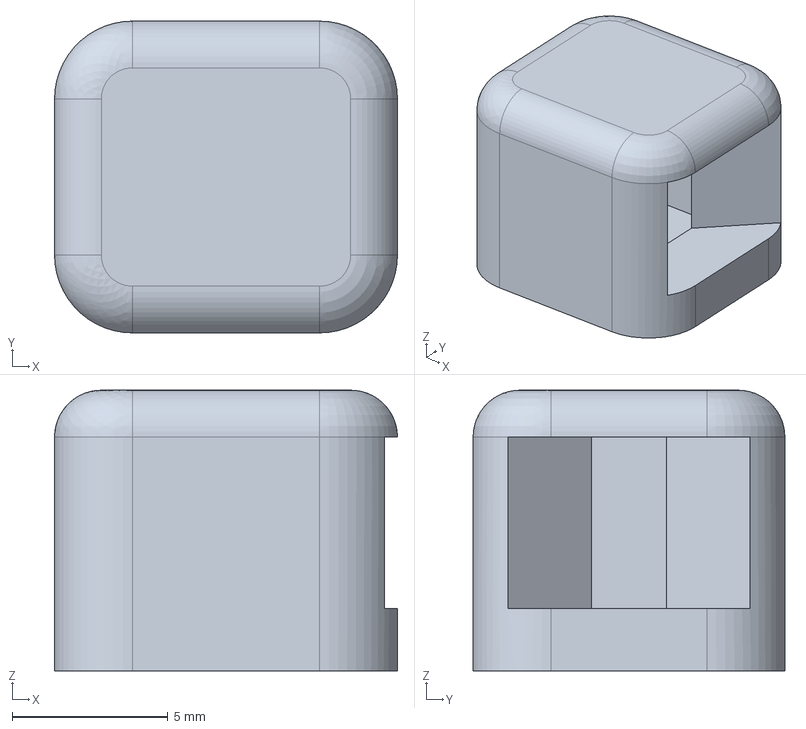
[picture p59: CAD file, 2026-11-09]
cad/robot_ir_hood.step
11.0 x 10.0 x 9.00 mm
