tuanito/2-wheel-balanced-bot/sim/meshes/front.stl

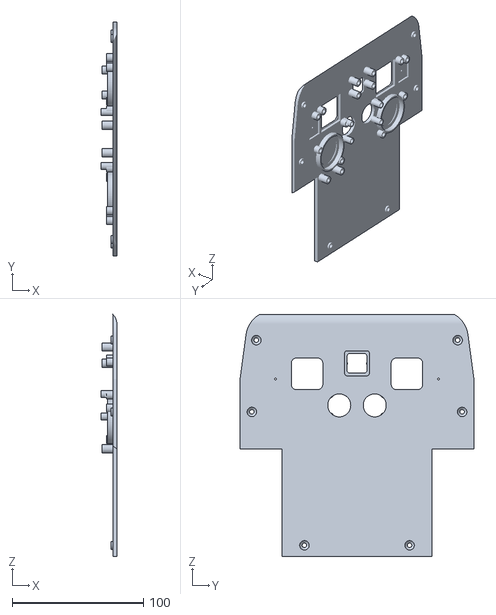
[picture p60: CAD file, 2026-11-09]
sim/meshes/front.stl
12.0 x 178.0 x 184.1
