tuanito/2-wheel-balanced-bot/cad/robot_shelf.step

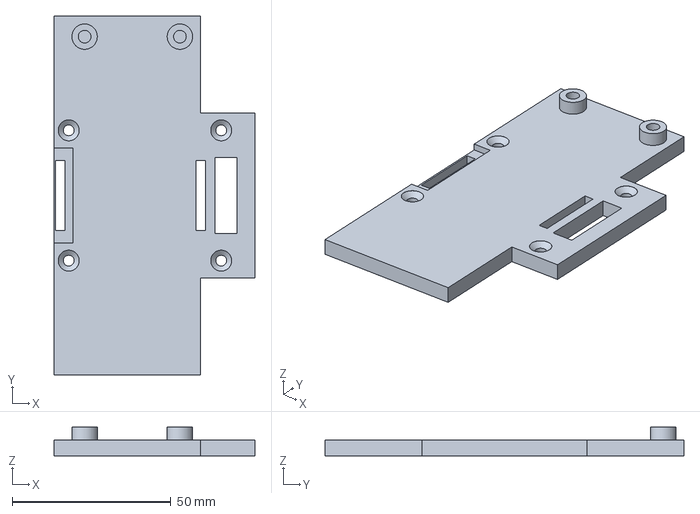
[picture p61: CAD file, 2026-11-09]
cad/robot_shelf.step
63.2 x 113.0 x 9.00 mm
