tuanito/2-wheel-balanced-bot/cad/robot_dock_ridge.step

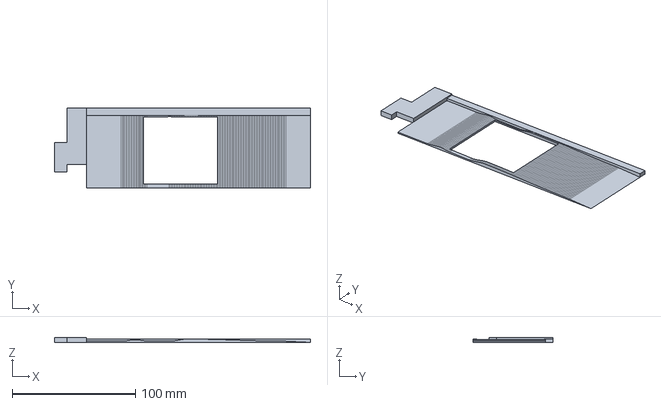
[picture p62: CAD file, 2026-11-09]
cad/robot_dock_ridge.step
207.5 x 65.0 x 4.00 mm
