tuanito/2-wheel-balanced-bot/cad/robot_dock_wing.step

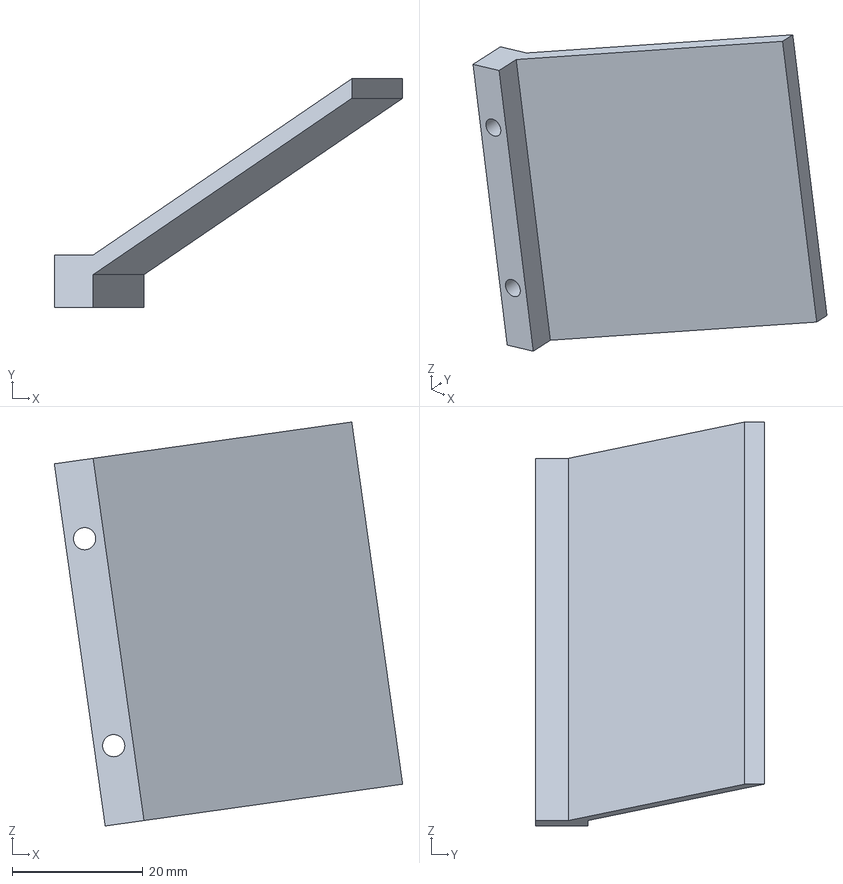
[picture p63: CAD file, 2026-11-09]
cad/robot_dock_wing.step
53.3 x 35.0 x 61.9 mm
