tuanito/2-wheel-balanced-bot/cad/robot_dock_ridge_insert.step

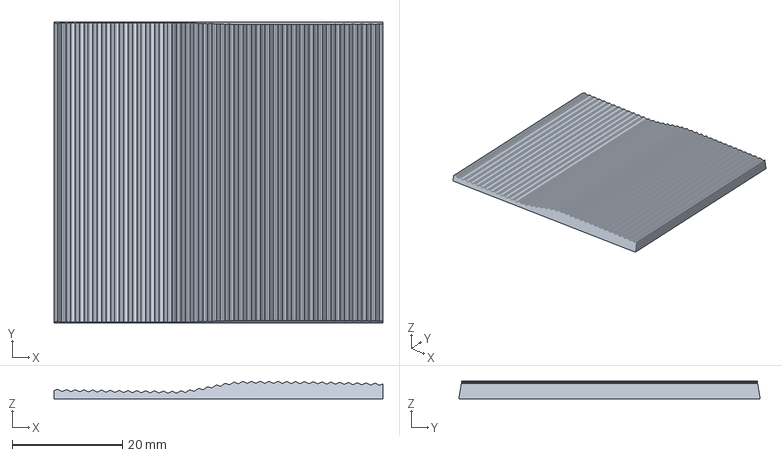
[picture p64: CAD file, 2026-11-09]
cad/robot_dock_ridge_insert.step
59.7 x 54.7 x 3.19 mm
