tuanito/2-wheel-balanced-bot/cad/robot_clamp_bar.step

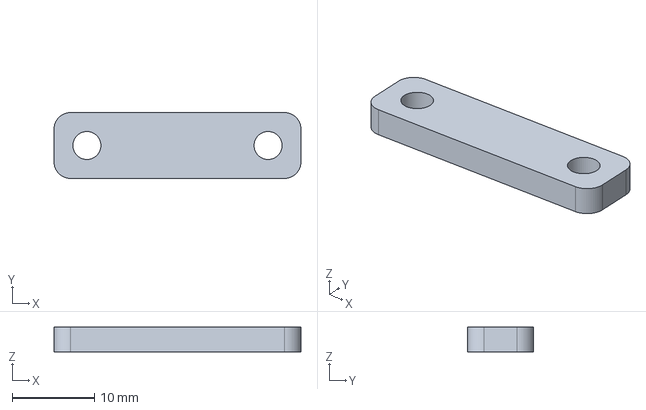
[picture p65: CAD file, 2026-11-09]
cad/robot_clamp_bar.step
30.0 x 8.00 x 3.00 mm
