tuanito/2-wheel-balanced-bot/cad/robot_dock.step

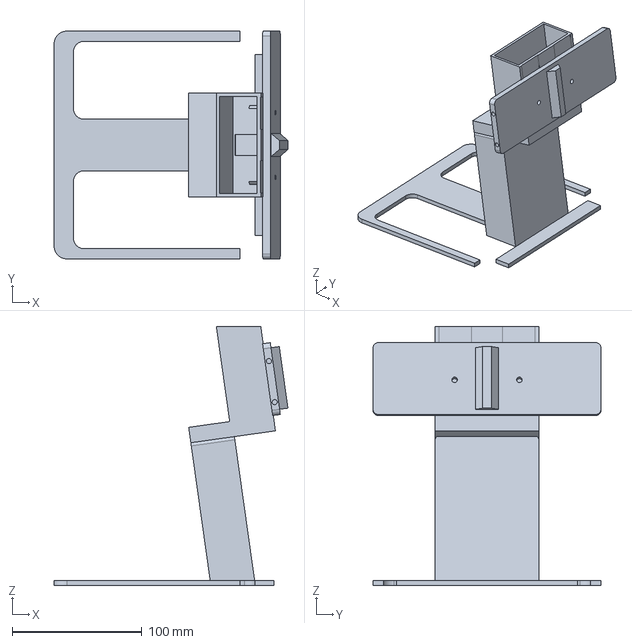
[picture p66: CAD file, 2026-11-09]
cad/robot_dock.step
180.6 x 176.0 x 200.0 mm
