tuanito/2-wheel-balanced-bot/cad/robot_charge_mat.step

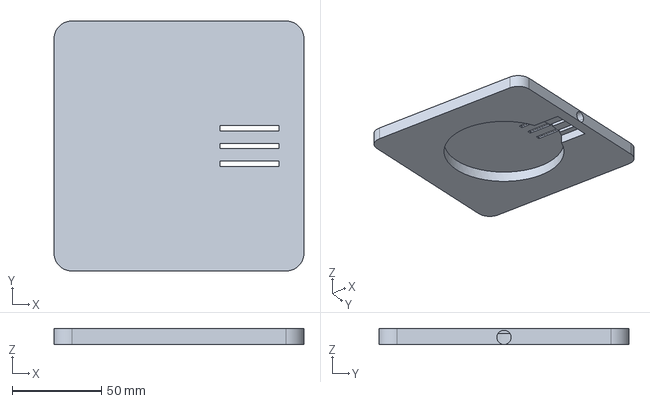
[picture p67: CAD file, 2026-11-09]
cad/robot_charge_mat.step
140.0 x 140.0 x 9.00 mm
