tuanito/2-wheel-balanced-bot/cad/robot_eye_diffuser.step

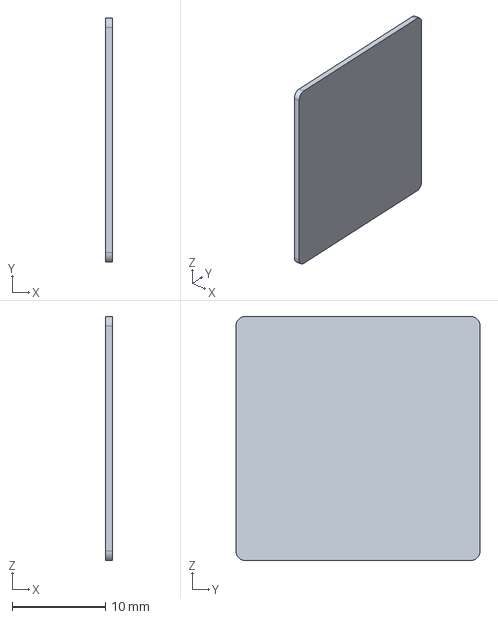
[picture p68: CAD file, 2026-11-09]
cad/robot_eye_diffuser.step
0.8 x 26.1 x 26.1 mm
