tuanito/2-wheel-balanced-bot/(list of files, cad)

Other CAD files:
sim/meshes/ring.stl
sim/meshes/cover.stl
sim/meshes/micc_l.stl
sim/meshes/ret_l.stl
sim/meshes/shelf.stl
cad/robot_carrier_plate.step
sim/meshes/lret_l.stl
cad/robot_mic_clamp.step
cad/robot_eye_retainer.step
cad/robot_light_retainer.step
cad/robot_tray.step
cad/robot_contact_plate.step
cad/robot_body.step
cad/mf6015_hex12_adapter.stl
cad/robot_body.stl
cad/robot_carrier_plate.stl
cad/robot_charge_mat.stl
cad/robot_clamp_bar.stl
cad/robot_coil_cap.stl
cad/robot_contact_plate.stl
cad/robot_cover.stl
cad/robot_dock_foot.stl
cad/robot_dock_head.stl
cad/robot_dock_mast.stl
cad/robot_dock_ridge.stl
cad/robot_dock_ridge_insert.stl
cad/robot_dock_wing.stl
cad/robot_eye_diffuser.stl
cad/robot_eye_retainer.stl
cad/robot_front.stl
cad/robot_ir_hood.stl
cad/robot_light_retainer.stl
cad/robot_mic_clamp.stl
cad/robot_shelf.stl
cad/robot_speaker_ring.stl
cad/robot_tray.stl
