tuanito/2-wheel-balanced-bot/site/files/descend_step-040-ok.jpg

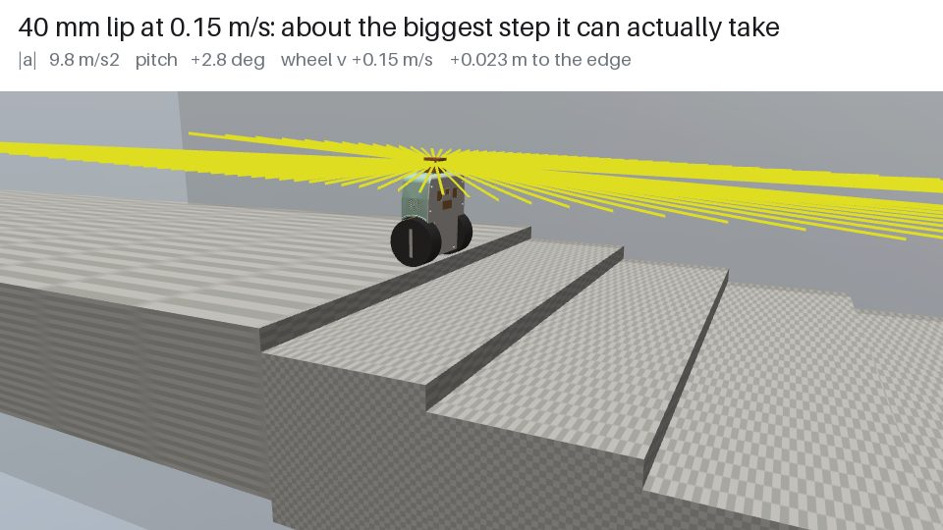
site/files/descend_step-040-ok.jpg
