tuanito/2-wheel-balanced-bot/site/files/descend_step-100-fast.jpg

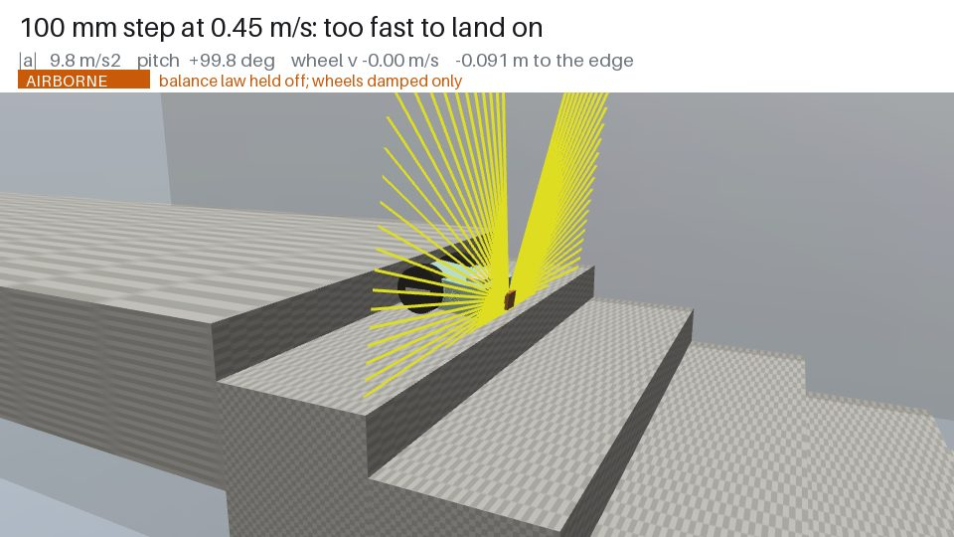
site/files/descend_step-100-fast.jpg
