tuanito/2-wheel-balanced-bot/site/files/descend_step-130-fail.jpg

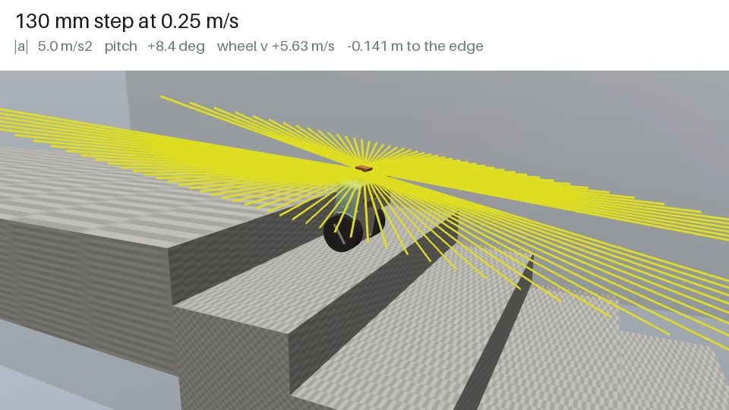
site/files/descend_step-130-fail.jpg
