tuanito/2-wheel-balanced-bot/site/files/descend_step-170-fail.jpg

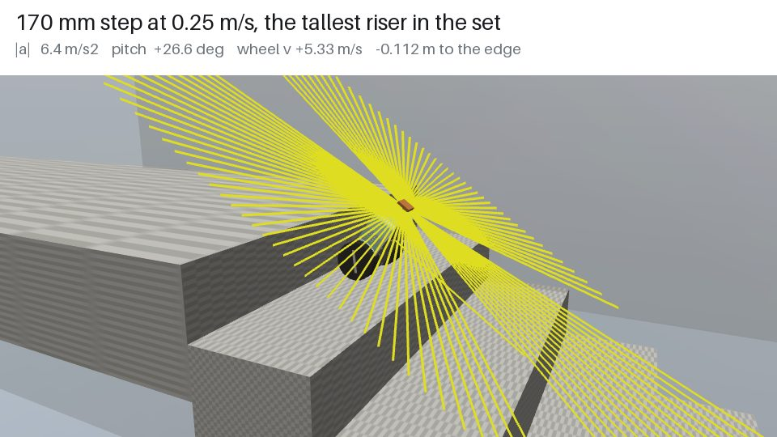
site/files/descend_step-170-fail.jpg
