tuanito/2-wheel-balanced-bot/sim/results/nav_data/map.png

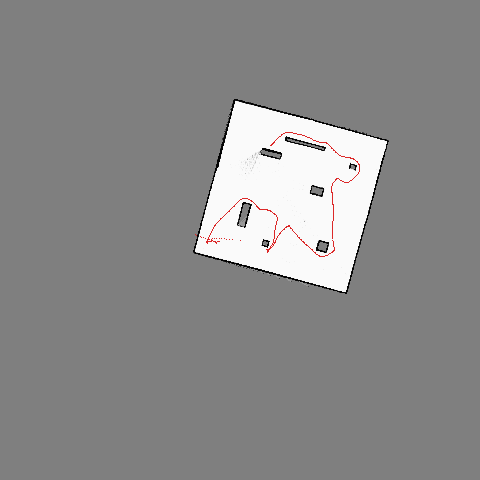
sim/results/nav_data/map.png
