tuanito/2-wheel-balanced-bot/sim/results/nav_map.png

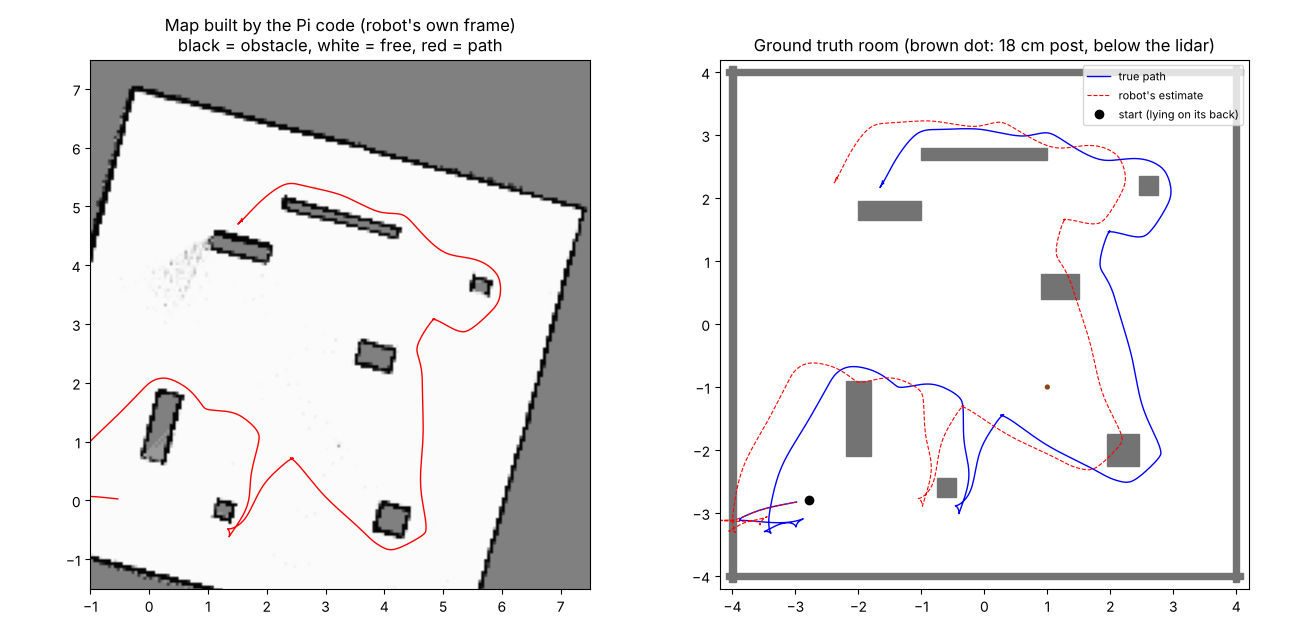
sim/results/nav_map.png
