tuanito/2-wheel-balanced-bot/sim/results/robot_c_mission.png

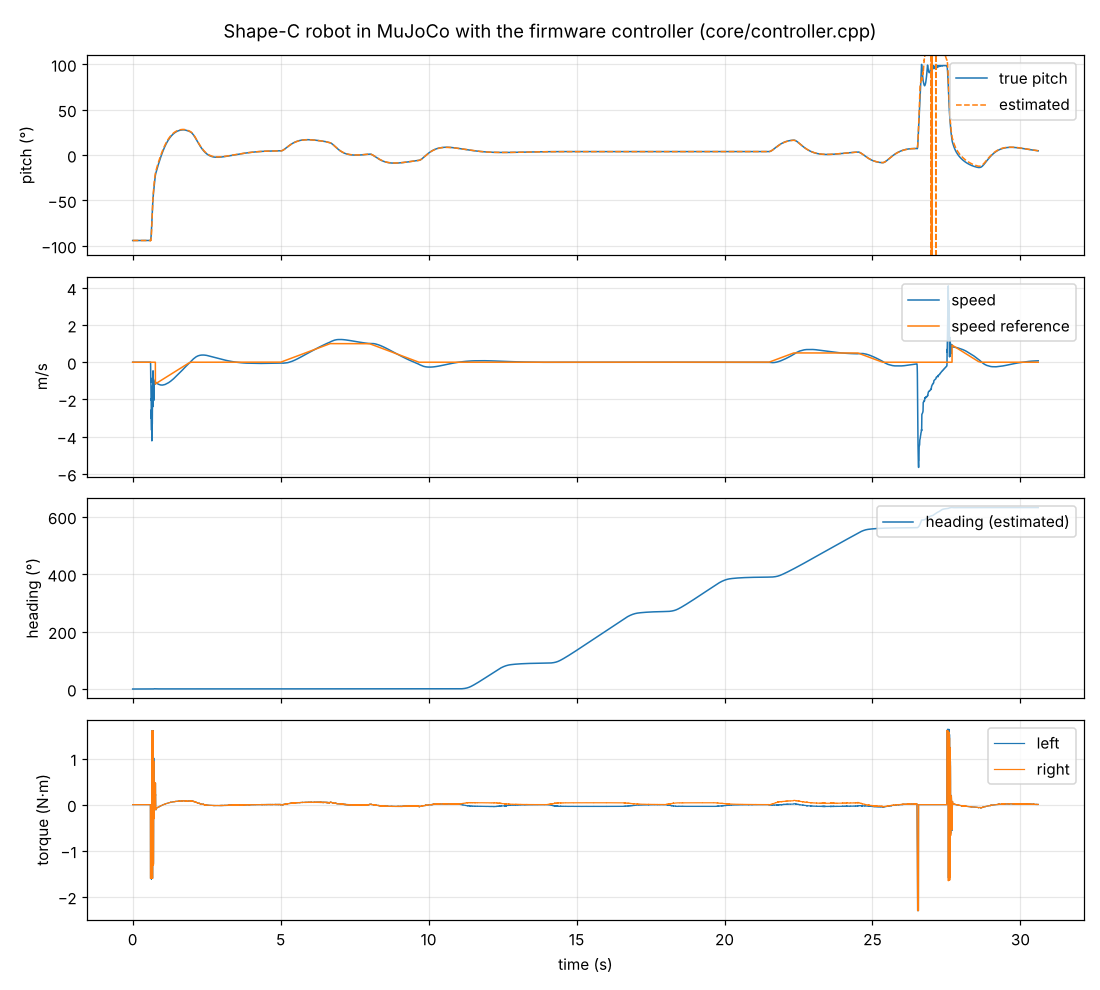
sim/results/robot_c_mission.png
