tuanito/2-wheel-balanced-bot/cad_src/case/robot_paths.py

"""Where everything lives on this machine.

The CAD and electrical scripts were written on the Claude VM, whose layout is

    /home/claude/case            the case sources (this directory)
    /home/claude/wheel_adapter   the wheel-adapter sources
    /home/claude/robot           the git repository
    /home/claude/models/bought   bought-part STEP models
    /home/claude/mf_step         the MF6015 motor STEP

In a git checkout the same files are cad_src/case, cad_src/wheel_adapter and the
repository root itself. Nothing below is hard-coded to either layout: the source
trees are found from this file's own location (it ships next to the case sources,
so it is in the right place on both machines), the repository by walking up to the
directory that holds firmware/ and sim/, and the VM paths remain as a last-resort
fallback. So the same code runs unchanged on the VM and on a developer machine.

Every root can be overridden by an environment variable:

    ROBOT_CASE  ROBOT_WHEEL_ADAPTER  ROBOT_ROOT  ROBOT_OUT  ROBOT_MODELS  ROBOT_MF6015_STEP

BOT_WS is also honoured, for the workspace layout tools/make_workspace.sh builds
(case/, wheel_adapter/, robot/, v2site/, bom/, models/, mf_step/ side by side, all
symlinked back into this repo). Each of its directories is used only if it exists, so a
partial workspace falls back to the layout found from this file.

From a script in this directory:   import robot_paths as RP
From anywhere else in the repo:    import sys, pathlib
                                   sys.path.insert(0, str(pathlib.Path(__file__).resolve()
                                                          .parents[1] / "cad_src" / "case"))
                                   import robot_paths as RP
"""
import os
import pathlib
import sys

Path = pathlib.Path
_VM = Path("/home/claude")          # the Claude VM layout, used only if it is really there


def _env(name):
    v = os.environ.get(name)
    return Path(v).expanduser() if v else None


_WS = _env("BOT_WS")                # workspace built by tools/make_workspace.sh, if any


def _ws(*parts):
    """A directory inside the BOT_WS workspace, but only if it is really there."""
    if _WS is None:
        return None
    p = _WS.joinpath(*parts)
    return p if p.is_dir() else None


# ---------------------------------------------------------------- source trees
# This file sits in the case source directory, so its own parent is the answer on
# both machines: /home/claude/case on the VM, <repo>/cad_src/case in a checkout.
CASE = _env("ROBOT_CASE") or _ws("case") or Path(__file__).resolve().parent
# ... and the wheel adapter is its sibling in both layouts.
WHEEL_ADAPTER = _env("ROBOT_WHEEL_ADAPTER") or _ws("wheel_adapter") or CASE.parent / "wheel_adapter"


def _find_repo():
    p = _env("ROBOT_ROOT") or _ws("robot")
    if p:
        return p
    for d in [CASE, *CASE.parents]:                     # a checkout: walk up to the root
        if (d / "firmware" / "esp32").is_dir() and (d / "sim").is_dir():
            return d
    if (_VM / "robot" / "sim").is_dir():                # the VM: the repo is a sibling
        return _VM / "robot"
    raise RuntimeError(
        "cannot find the repository root (no parent of %s holds both firmware/ and sim/, "
        "and %s does not exist). Set ROBOT_ROOT to the checkout." % (CASE, _VM / "robot"))


REPO = _find_repo()
SIM = REPO / "sim"
SITE = _ws("v2site") or REPO / "site"            # the published pages and their builders
BOM = _ws("bom") or REPO / "bom"
FIRMWARE_CONFIG = REPO / "firmware" / "esp32" / "include" / "config.h"
PI_INSTALL = REPO / "pi" / "install.sh"


def add_sources():
    """Put the case and wheel-adapter sources on sys.path (body_case, wiring, wheel_adapter...)."""
    for d in (WHEEL_ADAPTER, CASE):
        s = str(d)
        if s not in sys.path:
            sys.path.insert(0, s)


def source(name):
    """A case source file read as text (the scripts that exec parts of each other)."""
    return CASE / name


# ---------------------------------------------------------- generated artifacts
# Where assemble.py and the exporters write. On the VM this is /home/claude/case,
# exactly where they have always written; in a checkout it is cad_src/case, which
# .gitignore keeps out of git. Set ROBOT_OUT to collect them somewhere else.
OUT = _env("ROBOT_OUT") or CASE
ASSEMBLY = OUT / "assembly"

# Artifacts that one script writes and another reads, with the command that makes each.
MAKES = {
    "wiring_data.json":      "python cad_src/case/dump_wiring.py",
    "wiring_diagram.json":   "python cad_src/case/dump_wiring.py",
    "viewer_parts_v11.json": "python cad_src/case/export_viewer_data.py",
    "print_parts_v11.json":  "python cad_src/case/export_print_data.py",
    "real_fit_report.json":  "python cad_src/case/real_assembly.py",
    "wire_report.json":      "python cad_src/case/wire_check.py",
}


def out(name):
    """Where to write a generated artifact (creating the directory if needed)."""
    OUT.mkdir(parents=True, exist_ok=True)
    return OUT / name


def artifact(name):
    """Where to read a generated artifact: the first copy that exists."""
    tried = []
    for d in dict.fromkeys((OUT, CASE, _VM / "case", REPO / "elec")):   # dedup, keep order
        p = d / name
        tried.append(str(p))
        if p.exists():
            return p
    how = MAKES.get(name)
    raise FileNotFoundError(
        "%s not found. Looked in:\n  %s\n%s" % (
            name, "\n  ".join(tried),
            ("Generate it with:  %s  (needs cadquery)" % how) if how else ""))


# ------------------------------------------------------------- bought-part CAD
def models_dir():
    """Directory of bought-part STEP models (models/fetch_models.sh downloads them)."""
    p = _env("ROBOT_MODELS")
    if p:
        return p
    for d in (_ws("models", "bought"), REPO / "models" / "bought", _VM / "models" / "bought"):
        if d and d.is_dir():
            return d
    return REPO / "models" / "bought"


# How each motor's STEP is obtained. The MF6015's is NOT redistributable and not downloadable
# without going through the dealer's product page, so fetch_models.sh deliberately leaves it out;
# the MF7015's is a plain public download from the vendor, so fetch_models.sh takes it.
_MOTOR_STEP = {
    "mf6015": ("ROBOT_MF6015_STEP", "mf6015.step",
               "download it from the LKMTECH / dealer product page"),
    "mf7015": ("ROBOT_MF7015_STEP", "mf7015.step",
               "run models/fetch_models.sh, which downloads it from myactuator.com"),
}


def motor_step(profile="mf6015"):
    """The hub motor's STEP, by motor profile name. See _MOTOR_STEP for where each one comes from."""
    try:
        var, fname, how = _MOTOR_STEP[profile]
    except KeyError:
        raise KeyError("unknown motor profile %r: know %s" % (profile, sorted(_MOTOR_STEP)))
    _ws_step = _ws("mf_step")
    for p in (_env(var), models_dir() / fname,
              _ws_step / fname if _ws_step else None, _VM / "mf_step" / fname):
        if p and p.exists():
            return p
    raise FileNotFoundError(
        "%s motor STEP not found. It is not in the repo (models/bought/ is gitignored): %s, save it "
        "as %s, or point %s at it." % (profile.upper(), how, models_dir() / fname, var))


def mf6015_step():
    """Back-compatible alias: the MF6015 motor STEP. Prefer motor_step(profile)."""
    return motor_step("mf6015")
