tuanito/2-wheel-balanced-bot/site/build_stairs.py

"""Builds site/stairs.html from the clips sim/stairs_video.py rendered and the numbers it recorded.

Every caption, badge and figure on the page comes out of site/files/stairs_clips.json, which the video
script writes from each episode's own info dict. Nothing on the page is typed in by hand, so the page
cannot drift from the clips the way a written-up result drifts from the run it describes.

  python sim/stairs_video.py && python site/build_stairs.py
"""
import html, json, pathlib

HERE = pathlib.Path(__file__).parent
CLIPS = HERE / "files" / "stairs_clips.json"
AB = HERE / "files" / "stairs_ab.json"
DOWN = HERE / "files" / "descend_clips.json"
FLIGHT = HERE / "files" / "flight_clips.json"
OUT = HERE / "stairs.html"

NAV = [("index.html", "3D viewer"), ("wiring_boards.html", "Wiring diagram"), ("print.html", "How it prints"),
       ("docs.html", "README &amp; install"), ("code.html", "Source code"), ("bom.html", "Parts list"),
       ("standup.html", "Stand-up"), ("stairs.html", "Stairs")]

CSS = """:root{--bg:#f6f7f9;--fg:#1d2330;--mut:#667085;--ac:#2f6fd0;--card:#fff;--bd:#e2e5ea;--hd:#eef2f8;
 --pass:#15803d;--luck:#b45309;--fail:#b3261e}
@media (prefers-color-scheme:dark){:root:not([data-theme="light"]){--bg:#15171b;--fg:#e8eaee;--mut:#9aa2ae;
 --ac:#6ea3ff;--card:#1f2228;--bd:#30343c;--hd:#2a303a;--pass:#4ade80;--luck:#fbbf24;--fail:#f87171;
 color-scheme:dark}}
:root[data-theme="dark"]{--bg:#15171b;--fg:#e8eaee;--mut:#9aa2ae;--ac:#6ea3ff;--card:#1f2228;--bd:#30343c;
 --hd:#2a303a;--pass:#4ade80;--luck:#fbbf24;--fail:#f87171;color-scheme:dark}
*{box-sizing:border-box}html,body{margin:0;background:var(--bg);color:var(--fg);
 font:15px/1.45 -apple-system,system-ui,Segoe UI,Roboto,sans-serif}
header{padding:12px 14px 6px}h1{font-size:17px;margin:0 0 2px}header p{margin:0;color:var(--mut);font-size:13px;max-width:92ch}
a{color:var(--ac)}
nav.top{display:flex;gap:6px;overflow-x:auto;padding:6px 14px 8px;scrollbar-width:none}
nav.top::-webkit-scrollbar{display:none}
nav.top a{flex:none;border:1px solid var(--bd);background:var(--card);color:var(--fg);border-radius:999px;
 padding:7px 13px;font-size:14px;text-decoration:none}
nav.top a.on{background:var(--ac);border-color:var(--ac);color:#fff}
main{padding:0 14px 32px;max-width:1140px}
h2{font-size:15px;margin:24px 0 2px}p.sub{margin:0 0 8px;color:var(--mut);font-size:13px;max-width:92ch}
.cards{display:flex;flex-wrap:wrap;gap:8px;margin:8px 0 0}
.cards .c{flex:1 1 180px;min-width:0;background:var(--card);border:1px solid var(--bd);border-radius:12px;padding:10px 12px}
.cards .c .k{font-size:12.5px;color:var(--mut)}
.cards .c .v{font-family:ui-monospace,SFMono-Regular,Menlo,monospace;font-size:20px;margin-top:2px;font-variant-numeric:tabular-nums}
.cards .c .n{font-size:12px;color:var(--mut);margin-top:2px}
.cards .c.ok{border-left:3px solid var(--pass)}.cards .c.no{border-left:3px solid var(--fail)}
.grid{display:grid;grid-template-columns:repeat(auto-fit,minmax(330px,1fr));gap:12px;margin-top:12px}
.clip{background:var(--card);border:1px solid var(--bd);border-radius:12px;overflow:hidden;min-width:0}
.clip video{display:block;width:100%;height:auto;background:#000}
.clip .cap{padding:10px 12px 2px;font-size:13.5px;font-weight:600}
.clip .vd{margin:6px 12px 0;font-size:12px;border-radius:8px;padding:6px 9px;
 font-family:ui-monospace,SFMono-Regular,Menlo,monospace;line-height:1.35}
.vd.ok{color:var(--pass);background:rgba(21,128,61,.12)}
.vd.luck{color:var(--luck);background:rgba(180,83,9,.13)}
.vd.no{color:var(--fail);background:rgba(179,38,30,.12)}
.ro{display:grid;grid-template-columns:repeat(4,1fr);gap:1px;background:var(--bd);margin-top:10px;border-top:1px solid var(--bd)}
.ro div{background:var(--card);padding:7px 9px;min-width:0}
.ro .k{font-size:10.5px;color:var(--mut);text-transform:uppercase;letter-spacing:.04em;white-space:nowrap;overflow:hidden;text-overflow:ellipsis}
.ro .v{font-family:ui-monospace,SFMono-Regular,Menlo,monospace;font-size:13px;margin-top:1px;font-variant-numeric:tabular-nums}
.note{margin:10px 0 0;font-size:13.5px;color:var(--mut);max-width:92ch}
.note b{color:var(--fg)}
.why{display:grid;grid-template-columns:repeat(auto-fit,minmax(270px,1fr));gap:10px;margin-top:10px}
.why .w{background:var(--card);border:1px solid var(--bd);border-radius:12px;padding:12px 14px}
.why .w h3{font-size:14px;margin:0}.why .w p{margin:6px 0 0;font-size:13px;color:var(--mut)}
.wide{display:grid;grid-template-columns:1fr;gap:12px;margin-top:12px}
.two{display:grid;grid-template-columns:1fr 1fr;gap:8px;margin:6px 12px 0}
@media (max-width:620px){.two{grid-template-columns:1fr}}
.two .vd{margin:0}
.two .lbl{font-size:10.5px;text-transform:uppercase;letter-spacing:.05em;color:var(--mut);margin-bottom:3px}
.ro6{display:grid;grid-template-columns:repeat(6,1fr);gap:1px;background:var(--bd);margin-top:10px;border-top:1px solid var(--bd)}
.ro6 div{background:var(--card);padding:7px 9px;min-width:0}
.ro6 .k{font-size:10.5px;color:var(--mut);text-transform:uppercase;letter-spacing:.04em;white-space:nowrap;overflow:hidden;text-overflow:ellipsis}
.ro6 .v{font-family:ui-monospace,SFMono-Regular,Menlo,monospace;font-size:13px;margin-top:1px;font-variant-numeric:tabular-nums}
@media (max-width:620px){.ro6{grid-template-columns:repeat(3,1fr)}}
.tw{overflow-x:auto;margin-top:10px}
table{width:100%;border-collapse:collapse;font-size:13px}
th,td{text-align:right;padding:7px 9px;border-bottom:1px solid var(--bd);white-space:nowrap}
th:first-child,td:first-child{text-align:left}
th{font-size:11px;text-transform:uppercase;letter-spacing:.05em;color:var(--mut)}
td.m{font-family:ui-monospace,SFMono-Regular,Menlo,monospace;font-variant-numeric:tabular-nums}
footer{color:var(--mut);font-size:12.5px;margin-top:26px;border-top:1px solid var(--bd);padding-top:10px;max-width:92ch}"""

BAND = [("800 mm", "--", "--", "--"), ("500 mm", "26", "--", "--"), ("450 mm", "26-32", "26-32", "32"),
        ("400 mm", "26-35", "29-35", "35"), ("350 mm", "29-41", "32-41", "38-41"),
        ("300 mm", "32-47", "35-47", "41-47")]

WHY = [
    ("Never look",
     "At -2 for never looking against -10 for the drop, refusing to nod is correct arithmetic: a nod with "
     "an unlearned depth goes over the edge 30% of the time, so looking was worth -3 against a certain -2. "
     "The policy stopped nodding altogether - not one nod in twelve deterministic episodes."),
    ("Look, then fall downstairs",
     "At -8 against -8, measuring and then going over was worth +12 +2 -8 = +6, better than anything safe. "
     "That policy measured the riser to 44 +- 48 mm against the script's 205 +- 286, four times more "
     "accurate, and drove off the edge in 30 of 30 held-out episodes."),
    ("Reverse off the back of the world",
     "The simulated landing only ran 3 m behind the edge, and falling off it cost -5 while never looking "
     "cost -8. The policy drove backwards off the floor, which looked perfectly safe in the margin "
     "statistics. The landing now runs 8 m back."),
]


def badge(r):
    if not r["ok"]:
        return "no"
    return "luck" if "LUCKY" in r["line"] else "ok"


def cell(k, v):
    return f'<div><div class="k">{k}</div><div class="v">{v}</div></div>'


def side(r, which, name):
    """One recipe's verdict on this staircase, badged from its own telemetry."""
    d = r[which]
    cls = badge(d)      # amber for a right number off the wrong surface, same as the clips above
    return (f'<div><div class="lbl">{name}</div>'
            f'<div class="vd {cls}">{html.escape(d["line"])}</div></div>')


def down_clip(r):
    cls = "ok" if r["ok"] else "no"
    return f"""<figure class="clip">
<video controls preload="none" playsinline poster="files/descend_{r['slug']}.jpg">
 <source src="files/{r['file']}" type="video/mp4">Your browser cannot play this clip.</video>
<figcaption class="cap">{html.escape(r['caption'])}</figcaption>
<div class="vd {cls}">{html.escape(r['line'])}</div>
<div class="ro">{cell('riser', f"{r['rise_mm']:.0f} mm")}{cell('approach', f"{r['v_app']:.2f} m/s")}
{cell('peak pitch', f"{r['peak_deg']:.0f}&deg;")}{cell('airborne', f"{r['air_ms']:.0f} ms")}</div>
</figure>"""


def flight_clip(r):
    cls = "ok" if r["ok"] else "no"
    return f"""<figure class="clip">
<video controls preload="none" playsinline poster="files/flight_{r['slug']}.jpg">
 <source src="files/{r['file']}" type="video/mp4">Your browser cannot play this clip.</video>
<figcaption class="cap">{html.escape(r['caption'])}</figcaption>
<div class="vd {cls}">{html.escape(r['line'])}</div>
<div class="ro">{cell('riser', f"{r['rise_mm']:.0f} mm")}{cell('tread', f"{r['tread_mm']:.0f} mm")}
{cell('roll speed', f"{r['v']:.2f} m/s")}{cell('steps', f"{r['steps']} of 4")}</div>
</figure>"""


def pair(r):
    f, w = r["flick"], r["swing"]
    est = lambda d: "--" if d["rise_est_mm"] is None else f'{d["rise_est_mm"]} mm'
    return f"""<figure class="clip">
<video controls preload="none" playsinline poster="files/stairs_{r['slug']}.jpg">
 <source src="files/{r['file']}" type="video/mp4">Your browser cannot play this clip.</video>
<figcaption class="cap">Staircase {r['seed']} &mdash; riser {r['rise_mm']} mm, tread {r['tread_mm']} mm,
 starting {r['start_mm']} mm back</figcaption>
<div class="two">{side(r, 'flick', 'Flick')}{side(r, 'swing', 'Swing')}</div>
<div class="ro6">{cell('flick, read', est(f))}{cell('flick, returns', f['n_seen'])}
{cell('flick, landing', f"{f['margin_mm']} mm")}{cell('swing, read', est(w))}
{cell('swing, returns', w['n_seen'])}{cell('swing, landing', f"{w['margin_mm']} mm")}</div>
</figure>"""


def main():
    rows = json.loads(CLIPS.read_text())
    ab = json.loads(AB.read_text()) if AB.exists() else []
    ab_f = sum(1 for r in ab if r["flick"]["ok"])
    ab_s = sum(1 for r in ab if r["swing"]["ok"])
    # the swing's signature failure: plenty of returns ON the tread and still no riser, because the
    # landing it would be measured against never appeared in the same scan
    ab_blind = sum(1 for r in ab if r["swing"]["rise_est_mm"] is None and r["swing"]["n_seen"] >= 20)
    down = json.loads(DOWN.read_text()) if DOWN.exists() else []
    down_ok = sum(1 for r in down if r["ok"])
    flights = json.loads(FLIGHT.read_text()) if FLIGHT.exists() else []
    flight_ok = sum(1 for r in flights if r["ok"])
    good = [r for r in rows if r["ok"] and "LUCKY" not in r["line"]]
    lucky = [r for r in rows if r["ok"] and "LUCKY" in r["line"]]
    clips = []
    for r in rows:
        est = "--" if r["rise_est_mm"] != r["rise_est_mm"] else f'{r["rise_est_mm"]:.0f} mm'
        clips.append(f'''<figure class="clip">
<video controls preload="none" playsinline poster="files/stairs_{r['slug']}.jpg">
 <source src="files/{r['file']}" type="video/mp4">Your browser cannot play this clip.</video>
<figcaption class="cap">{html.escape(r['caption'])}</figcaption>
<div class="vd {badge(r)}">{html.escape(r['line'])}</div>
<div class="ro">{cell('riser, true', f"{r['rise_true_mm']:.0f} mm")}{cell('riser, read', est)}
{cell('returns on tread', r['n_seen'])}{cell('landing left', f"{r['margin_mm']:.0f} mm")}</div>
<div class="ro">{cell('flick target', f"{r['nod_target']:.2f} rad" if r['nod_target'] else '--')}
{cell('taken at', f"{r['nod_at_mm']} mm" if r['nod_at_mm'] is not None else '--')}
{cell('peak pitch', f"{r['peak_deg']:.1f}&deg;")}{cell('seed', r['seed'])}</div>
</figure>''')
    band = "".join(f'<tr><td>{d}</td><td class="m">{a}</td><td class="m">{b}</td><td class="m">{c}</td></tr>'
                   for d, a, b, c in BAND)
    why = "".join(f'<div class="w"><h3>{t}</h3><p>{html.escape(p)}</p></div>' for t, p in WHY)
    nav = "".join(f'<a href="{h}"{" class=\"on\" aria-current=\"page\"" if h == "stairs.html" else ""}>{t}</a>'
                  for h, t in NAV)
    OUT.write_text(f'''<!DOCTYPE html>
<html lang="en"><head><meta charset="utf-8"><meta name="viewport" content="width=device-width,initial-scale=1">
<title>Balancing robot V1.1 – measuring a staircase</title>
<style>{CSS}</style></head><body>
<header><h1>Balancing robot V1.1 &mdash; measuring a staircase by nodding</h1>
<p>The robot has to know how tall the first step is before it can think about going down it. It has one
lidar, 231 mm up, which sees nothing of the floor while it is upright &mdash; so it has to tip forward,
and a two-wheel balancer cannot tip forward without driving forward. Twelve episodes of what that costs
and every way it goes wrong, then ten staircases taken twice over &mdash; once with each way of looking,
side by side.</p></header>
<nav class="top" aria-label="Pages">{nav}</nav>
<main>
<div class="cards">
 <div class="c ok"><div class="k">Flick, held-out stairs</div><div class="v">0.390</div>
  <div class="n">78 of 200 staircases, risers 80&ndash;170 mm, seeds never trained on</div></div>
 <div class="c"><div class="k">Swing, the same 200</div><div class="v">0.290</div>
  <div class="n">58 of 200; the gap is 2.1&sigma;, so the flick really is ahead</div></div>
 <div class="c"><div class="k">Ceiling for any fixed recipe</div><div class="v">0.50</div>
  <div class="n">grid search: one nod carries no clue which riser it faces</div></div>
 <div class="c no"><div class="k">Learned policy, same stairs</div><div class="v">0.00</div>
  <div class="n">eleven PPO runs, three reward bugs &mdash; all mine</div></div>
</div>
<p class="note"><b>How to read the clips.</b> The yellow fan is the lidar, drawn where its rays actually
land; the stairwell walls are made see-through for the camera only. Each clip ends with what that
episode really did, taken from its own telemetry after it ran &mdash; not from what it was meant to show.
A success means all three at once: the riser measured to within 20 mm, the robot still upright, and at
least 100 mm of landing left between the wheels and the drop. <b>The clips that work are selected
episodes</b>: the recipe succeeds on 39% of staircases, so the environment was asked for seeds until the
outcome matched, and the seed is listed under each clip. The honest rate is the 0.390 above, not 5 of 12.
The ten pairs further down are <em>not</em> selected, and are a fair sample.</p>

<h2>Twelve episodes</h2>
<p class="sub">{len(good)} clean successes, {len(lucky)} right for the wrong reason, {len(rows) - len(good) - len(lucky)} failures.</p>
<div class="grid">{''.join(clips)}</div>

<h2>Flick against swing, on the same staircase</h2>
<p class="sub">{len(ab)} pairs, left and right of one clip: identical riser, tread, start distance, robot and
CAN latency, one recipe each. <b>Nothing here is selected</b> &mdash; the seeds are simply the first
{len(ab)} of the evaluation set (20000 onwards) and the staircase is whatever that seed drew, so the tally
below is an unbiased, if small, sample of the 0.390 and 0.290 above. On these {len(ab)}: flick {ab_f}/{len(ab)},
swing {ab_s}/{len(ab)}.</p>
<div class="wide">{"".join(pair(r) for r in ab)}</div>
<p class="note"><b>What the pairs show that the averages do not.</b> The swing's distinctive failure
&mdash; the one the flick almost never has, 38% of episodes against 7% &mdash; is not a bad number, it is
<b>no number</b>: it stops close, pitches down, and every ray clears the landing and lands on the tread. A riser is the difference between two surfaces, so hundreds of returns on the tread
measure nothing with no landing left to subtract from. {"One" if ab_blind == 1 else ab_blind} of these ten clips fails exactly that
way, with 597 rays on the tread and no number out of them. The flick does not have the problem because it
takes its look from further back while reversing, so the landing stays in the scan; what it does
instead, when it fails, is overfly the first tread and measure a surface two steps down.</p>

<h2>Two ways to take the look</h2>
<p class="sub">A <b>flick</b> is one-sided: gravity acts forward for the whole nod, so it costs
0.1&ndash;1.1 m of travel towards the drop. A <b>swing</b> leans back for as long as it leans forward,
so it travels almost nothing &mdash; 650 mm of standoff became 638 mm across six cycles &mdash; and its
amplitude grows each cycle, because the angle that sees a 170 mm riser is not the one that sees an
80 mm riser and the robot cannot know which it faces until it has measured it.</p>
<div class="tw"><table><thead><tr><th>look</th><th>success</th><th>read anything</th><th>riser error</th>
<th>landing left</th><th>worst</th><th>fell or went over</th></tr></thead><tbody>
<tr><td>one-sided flick</td><td class="m">0.390</td><td class="m">0.93</td>
<td class="m">202 &plusmn; 297 mm</td><td class="m">207 mm</td><td class="m">&minus;68 mm</td>
<td class="m">0.105</td></tr>
<tr><td>creep in, then swing</td><td class="m">0.290</td><td class="m">0.62</td>
<td class="m">213 &plusmn; 299 mm</td><td class="m">249 mm</td><td class="m">&minus;386 mm</td>
<td class="m">0.185</td></tr>
</tbody></table></div>
<p class="note">Same harness, same 200 held-out staircases, seeds 20000 onwards. The flick wins by
10 points, and at 2.1&sigma; over 200 episodes that gap is real &mdash; an earlier 30-episode run put it
at 14 points, which was 1.2&sigma; and would have settled nothing. <b>The swing loses twice over.</b> It
reads nothing at all in 38% of episodes against the flick's 7%, and it goes over the edge <em>more</em>
often, 0.155 against 0.080, not less: it creeps to a fixed standoff and never reverses, so a misjudged
stop keeps going forward, while backing away from the drop is part of what the flick is doing anyway.
On a staircase whose riser is already known it is much the better look &mdash; 6 of 6 successes at 5 mm
of error on a 100 mm riser, and it barely translates, 650 mm of standoff becoming 638 mm over six
cycles. It loses across <em>unknown</em> staircases because the amplitude it can safely reach caps the
angle, and a tall riser needs an angle it cannot get to from a standoff it can survive.</p>
<p class="note"><b>And it cannot be done from close in.</b> Creeping to 150 mm is safe &mdash; the robot
gets there without trouble and the swing is stable &mdash; and useless: 0 to 3 returns on the first
tread, the riser read 469 mm wrong. Closer is worse, not better. The step nose subtends a larger angle
the nearer you are, so the pitch needed to see past it rises: 41&ndash;50&deg; at 200 mm, roughly
60&ndash;70&deg; at 150 mm, while above about 0.8 rad of amplitude the swing loses the robot. The limit
is the lidar sitting 231 mm up, not the controller. A cheap time-of-flight sensor at ~80 mm would see
the first tread from 600 mm with a 20&deg; nod and make the whole manoeuvre easy.</p>

<h2>A sensor that does not need the nod</h2>
<p class="sub">Every number above is limited by one thing. A ray reaches the first tread only if it
clears the step nose and lands before the next one, which needs <b>D &lt; h &times; tread / rise</b>,
and the landing hides everything below it short of the edge &mdash; so the vertical riser face is
never visible from behind the edge, at any angle. The limit is the sensor's <b>height</b>. At the
lidar's 231 mm a 170 mm riser is out of reach beyond 408 mm; at the sonar's 134 mm, beyond 237 mm.
Mounting a depth sensor low would be the worst place for it.</p>
<p class="note">A <b>VL53L5CX</b> does not reach further &mdash; it obeys the same geometry &mdash; it
reaches <em>simultaneously</em>. The lidar has one scan plane and has to pitch the whole robot to put
that plane inside the band, which costs travel towards the drop and is why the nod recipes answer a
third of the time. 45&deg; of vertical field of view spans every angle in the band at once, so the
robot stands still at 260 mm and the answer arrives at 15 Hz. Same 80 held-out staircases:</p>
<div class="tw"><table><thead><tr><th>recipe</th><th>success</th><th>answers</th><th>riser error</th>
<th>worst margin</th><th>fell or went over</th></tr></thead><tbody>
<tr><td>flick, single-shot estimator</td><td class="m">0.362</td><td class="m">77/80</td>
<td class="m">220 &plusmn; 304 mm</td><td class="m">&minus;65 mm</td><td class="m">15/80</td></tr>
<tr><td>creep, wind, look, judge + sonar</td><td class="m">0.300</td><td class="m">27/80</td>
<td class="m">8 &plusmn; 7 mm</td><td class="m">+75 mm</td><td class="m">0/80</td></tr>
<tr><td><b>stand still + VL53L5CX</b></td><td class="m"><b>0.938</b></td><td class="m">80/80</td>
<td class="m">13 &plusmn; 5 mm</td><td class="m">+185 mm</td><td class="m">0/80</td></tr>
</tbody></table></div>
<p class="note">That 0.938 is <em>after</em> modelling a zone as the cone it really is &mdash; five
sub-rays per zone, nearest taken, as the part reports. One ray per zone centre deletes every mixed
pixel from a problem that is entirely about a depth discontinuity, and flattered it to 1.000 at
3.8 mm. The flattering number was the model, not the sensor.</p>

<h2>Four steps in a row</h2>
<p class="sub">{flight_ok} of {len(flights)} flights took all four steps. The cycle is: roll at a
measured speed, <b>commit</b> 20 mm before an edge the array has already located, hold attitude
through the landing, settle, back off to 75% of the tread &mdash; which is both where the array
measures best and far enough to approach the next edge deliberately &mdash; and repeat.</p>
<p class="note"><b>Committing is the whole trick.</b> Reacting cannot work: rolling off a lip at
walking pace produces no free fall at all, because the wheel stays on the corner the whole way down,
so the accelerometer never sees anything to react to. Meanwhile the velocity loop watches its support
vanish and drives the wheels to &minus;4.9 m/s. The robot does not need to detect the edge though
&mdash; it measured it. Holding attitude across the lip with the speed loop off takes a 100 mm step
from 0% to 92%, and a 170 mm step from 0% to 75%.</p>
<p class="note"><b>And it stays square.</b> A step taken skewed lands on one wheel, which is the one
failure the attitude hold cannot save: at 10&deg; off square the success rate collapses to 10&ndash;15%
against 65&ndash;90% when square. The yaw controller holds the heading the robot approached on, and
across four landings the drift stays under <b>0.3&deg;</b>. Worth knowing: the 8&nbsp;&times;&nbsp;8
array <em>cannot</em> measure that skew &mdash; at a 280 mm standoff 5&deg; moves the edge distance by
about 1 mm, well under the range noise &mdash; so squareness has to be held, not sensed.</p>
<div class="grid">{"".join(flight_clip(r) for r in flights)}</div>

<h2>Going down: {len(down)} attempts at a single step</h2>
<p class="sub">{down_ok} landed it. Mapping first, because it decides the shape of any descent: the
occlusion condition for the <em>k</em>-th tread reduces to the same D &lt; h &times; tread / rise with
no k in it, so a staircase is self-similar and anything that sees the first tread can geometrically
see them all. What limits the map is resolution &mdash; 8 rows resolve about <b>2 to 2.5 treads</b>,
the second to 25&ndash;30 mm. A one-step lookahead, not a flight.</p>
<p class="note"><b>And it cannot take the step.</b> Judged on staying under 46&deg;, one step at a
time: 25% at a 40 mm lip, 8% at 80 mm, <b>0% from 100 mm up</b>. The enemy is not the drop, it is the
robot's own velocity loop: one axle means both wheels leave the ground together, and for ~150 ms the
balance law servos against nothing &mdash; unloaded wheels run from 0.56 to 5.78 m/s in 50 ms and the
reaction throws the body to 90&ndash;110&deg;. The accelerometer sees the whole event (|a| falls to
~2 m/s&sup2; in free fall, spikes to ~176 on touchdown), so the controller now holds the balance law
off while airborne and damps the wheels only. Compare the two 40 mm clips: with the catch the body
peaks at 7&deg;, without it at 94&deg;. It is a real fix for a real bug, and it is still not a step
primitive. That needs to be trained, the way the stand-up was.</p>
<div class="grid">{"".join(down_clip(r) for r in down)}</div>

<h2>Why it is this hard</h2>
<p class="sub">Where the first tread is visible from, measured kinematically: body pitch in degrees that
puts returns on it, against how far back the robot stands. Beyond about 550 mm there is no angle that
works &mdash; the ray that clears the step nose already overflies the whole first tread.</p>
<div class="tw"><table><thead><tr><th>standoff</th><th>80 mm riser</th><th>100 mm riser</th>
<th>170 mm riser</th></tr></thead><tbody>{band}</tbody></table></div>
<p class="note">At a 170 mm riser that band is one three-degree cell wide per standoff, which is why a
fixed recipe scores 0 out of 10 there while managing 0.60 at 130 mm. And the nod is not free: gravity
acting over the time the body is tilted adds about 1 m/s of forward speed per 34&deg; of lean, and
shedding it costs 0.2&ndash;1.1 m of travel towards the drop. Entering the nod <em>reversing</em> is what
pays for it; entering it rolling forwards loses the robot outright, which is the clip above.</p>

<h2>Three ways the reward was wrong</h2>
<p class="sub">Each failure was the optimiser reading my numbers correctly.</p>
<div class="why">{why}</div>
<p class="note">The rule they share is now an assertion that runs when the environment is imported: the
drop has to cost more than the best possible reading is worth, and never looking has to cost more than
a safe bad look.</p>

<footer>Rendered by <span class="mono">sim/stairs_video.py</span> through the same environment, controller,
sensor noise and estimator as <span class="mono">ml/evaluate_stairs.py</span>; this page is generated from
the clips' own telemetry by <span class="mono">site/build_stairs.py</span>.</footer>
</main></body></html>''')
    print(f"wrote {OUT} ({OUT.stat().st_size // 1024} kB), {len(rows)} clips, "
          f"{sum(r['kb'] for r in rows) // 1024} MB of video")


if __name__ == "__main__":
    main()
