tuanito/2-wheel-balanced-bot/cad_src/case/real_parts.py

"""Bought parts as real 3D models, placed in the robot frame (x forward, y left, z up, origin on the axle).

Every part says where its geometry comes from:
  STEP   - manufacturer / published model, downloaded (models/bought/)
  DRAW   - built here from the official mechanical drawing (models/drawings/)
  LIST   - outer envelope from the seller's listed dimensions (no model published): a box, labelled as such
"""
import math, cadquery as cq
import body_case as bc
from load_models import load

AX = {"x": 0, "y": 1, "z": 2}

def orient(shape, xr, yr, zr):
    """Rigid rotation: robot x = model axis xr (e.g. '-z'), etc. Must be a proper rotation."""
    rows = []
    for a in (xr, yr, zr):
        r = [0.0, 0.0, 0.0]; r[AX[a[-1]]] = -1.0 if a[0] == "-" else 1.0; rows.append(r)
    det = (rows[0][0] * (rows[1][1] * rows[2][2] - rows[1][2] * rows[2][1]) - rows[0][1] * (rows[1][0] * rows[2][2] - rows[1][2] * rows[2][0])
           + rows[0][2] * (rows[1][0] * rows[2][1] - rows[1][1] * rows[2][0]))
    assert abs(det - 1) < 1e-9, (xr, yr, zr)
    from OCP.gp import gp_Trsf
    from OCP.BRepBuilderAPI import BRepBuilderAPI_Transform
    t = gp_Trsf()
    t.SetValues(rows[0][0], rows[0][1], rows[0][2], 0, rows[1][0], rows[1][1], rows[1][2], 0, rows[2][0], rows[2][1], rows[2][2], 0)
    out = cq.Shape.cast(BRepBuilderAPI_Transform(shape.wrapped, t, True).Shape())
    return out, (lambda p: tuple(sum(rows[i][j] * p[j] for j in range(3)) for i in range(3)))

PLACE = {}   # name -> (axes, ref_model, target): to map model-frame pin positions to the robot frame
def to_robot(name, p):
    axes, ref, tgt = PLACE[name]
    _, R = orient(cq.Solid.makeBox(1, 1, 1), *axes)
    a, r = R(p), R(ref)
    return tuple(tgt[i] + a[i] - r[i] for i in range(3))

def place(shape, axes, ref_model, target, name=None):
    if name: PLACE[name] = (axes, ref_model, target)
    s, R = orient(shape, *axes)
    r = R(ref_model)
    return s.translate((target[0] - r[0], target[1] - r[1], target[2] - r[2]))

def box(x0, x1, y0, y1, z0, z1):
    return cq.Solid.makeBox(x1 - x0, y1 - y0, z1 - z0, cq.Vector(x0, y0, z0))

def cyl(p, d, h, axis):   # cylinder from point p along +axis
    return cq.Solid.makeCylinder(d / 2, h, cq.Vector(*p), cq.Vector(*axis))

# ---------------- built from official drawings ----------------
def pi_zero_2w(header=True):
    """Raspberry Pi Zero 2 W, from the official mechanical drawing (RP-008358): 65 x 30 PCB, holes 3.5 in, 58 x 23,
    2x20 GPIO header centred 32.5 from the left / 3.5 from the top edge, mini-HDMI at 12.4, micro-USB at 41.4 and 54
    on the bottom edge, CSI on the right end. Board frame: x along 65, y along 30 (0 = bottom edge), z up (PCB top = 1.0).
    Connector heights from their datasheets (mini-HDMI 3.2, micro-USB B 2.6, CSI 1.2 mm, 22-pin FPC)."""
    pcb = cq.Workplane().add(box(0, 65, 0, 30, 0, 1.0)).edges("|Z").fillet(3.0).val()
    for (hx, hy) in ((3.5, 3.5), (61.5, 3.5), (61.5, 26.5), (3.5, 26.5)):
        pcb = pcb.cut(cyl((hx, hy, -1), 2.75, 3, (0, 0, 1)))
    parts = [pcb,
             box(12.4 - 5.6, 12.4 + 5.6, -0.5, 7.0, 1.0, 4.2),          # mini-HDMI
             box(41.4 - 4.0, 41.4 + 4.0, -1.0, 4.6, 1.0, 3.6),          # micro-USB (OTG data)
             box(54.0 - 4.0, 54.0 + 4.0, -1.0, 4.6, 1.0, 3.6),          # micro-USB (power)
             box(61.0, 65.5, 7.5, 22.5, 1.0, 2.2),                      # CSI 22-pin FPC connector
             box(-1.5, 11.0, 9.5, 21.0, -1.3, 0.0),                     # microSD socket + card (underside)
             box(20.0, 34.0, 8.0, 22.0, 1.0, 7.0)]                      # RP3A0 SiP + small heatsink (14 x 14 x 5)
    if header:   # soldered 2x20 male header: 2.5 mm plastic, pins 6 mm above
        hx0 = 32.5 - 19 * 2.54 / 2 - 1.27
        parts.append(box(hx0, hx0 + 20 * 2.54, 30 - 3.5 - 2.54 / 2 - 1.27, 30 - 3.5 + 2.54 / 2 + 1.27 - 2.54, 1.0, 3.5))
        parts.append(box(hx0 + 0.6, hx0 + 20 * 2.54 - 0.6, 30 - 3.5 - 2.54 - 0.6 + 1.27, 30 - 3.5 + 0.6 + 1.27 - 1.27, 3.5, 9.5))
    return cq.Compound.makeCompound(parts)

def pi_gpio(pin):
    """Board-frame (x, y) of a GPIO header pin (1..40). Pin 1 is at the left end, inner row (towards the board centre)."""
    col = (pin - 1) // 2; inner = (pin % 2 == 1)
    x = 32.5 - 19 * 2.54 / 2 + col * 2.54
    y = 30 - 3.5 - (2.54 / 2 if inner else -2.54 / 2)
    return x, y
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
