tuanito/2-wheel-balanced-bot/(commit log)

2026-11-09 Balancing robot V1.1: firmware, Pi software, sim, CAD sources + exports, BOM
    Claude-Session: https://claude.ai/code/session_01Fg7Pb2xfJ1nQFp1vCD25rQ
    [body.stl, cap.stl, cover.stl, front.stl, lret_l.stl, lret_r.stl, mf6015_hex12_adapter.step, mf6015_hex12_adapter.stl]
2026-11-09 Learned stand-up: RL training on the Mac (ml/), controller hook standup_mode
    - core: standup_mode 0 = hand-tuned (default, unchanged), 1 = neural policy from
    standup_policy.hpp (placeholder: no policy yet -> falls back to 0), 2 = torque
    from outside for training; standup_obs() gives the same inputs in sim and robot
    - sim: bot_standup / bot_standup_obs C API; botsim loads libbot.dylib on macOS
    - ml: gymnasium env around the MuJoCo sim + real controller, PPO training,
    evaluation vs hand-tuned on the run_tests robots, export to C++, Mac setup
    - firmware: botcore synced (builds for esp32s3)
    Claude-Session: https://claude.ai/code/sess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
2026-11-09 Site: the published artifact (3D viewer, wiring, print guide, BOM, docs, videos)
    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
2026-11-09 CLAUDE.md + all tooling in the repo: CAD/site/BOM scripts run from a checkout
    - CLAUDE.md: project overview, layout, build/check commands, rules (no secrets,
    dock safety, keyed power plugs), current state and open points
    - scripts find their files via BOT_WS (tools/make_workspace.sh links ~/bot-ws
    into the repo) instead of hard-coded workspace paths
    - site/: builders + templates next to the built pages
    - tools/: site_rebuild, cad_baseline, wc_power, sync_site
    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
2026-11-09 sim: make the MuJoCo models' meshdir relative, so they load anywhere
    build_model.py wrote the absolute path of the machine that generated the
    model into <compiler meshdir="...">, so every checked-in model pointed at
    /home/claude/robot/sim and ml/setup_mac.sh failed its own smoke test with
    "Error opening file '/home/claude/robot/sim/meshes/tray.stl'".
    Every model is loaded with from_xml_path, so a relative meshdir resolves
    against the XML's own directory: meshdir="." is correct on any machine.
    Fixed in the generator and in the four checked-in models; regenerating
    robot_c.xml now reproduces it byte for byte apart from that line.
    [build_model.py]
2026-11-09 cad_src, elec: find the source trees at runtime instead of hard-coding them
    These scripts were written on a machine that kept the sources in
    /home/claude/case and /home/claude/wheel_adapter and the repo in
    /home/claude/robot, and 36 of those paths were hard-coded. None of them
    existed in a checkout, so assemble.py, the exporters, wire_check.py,
    erc.py and can_ground_check.py all failed immediately.
    New cad_src/case/robot_paths.py works out where everything is rather
    than being told. It ships next to the case sources, so its own directory
    is the answer in both layouts; the wheel adapter is its sibling in both;
    the repo is found by walking up to the directory holding firmware/ and
    sim/. The o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
    [can_ground_check.py, dump_wiring.py, erc.py, export_viewer_real.py]
2026-11-09 CLAUDE.md: bring the build and check notes up to date
    The file arrived from the other branch describing the repo before the
    scripts landed. Corrected:
    - the build/check block now points at ./check.sh, core/build_lib.sh,
    sim/rebuild.sh, ml/run_training.sh and cad_src/rebuild.sh, with the
    by-hand commands kept underneath for single steps
    - "CAD / wiring / site scripts expect the old workspace layout: run
    tools/make_workspace.sh once" is no longer true. They find their files
    through cad_src/case/robot_paths.py and a plain checkout needs no setup;
    BOT_WS is still honoured, so make_workspace.sh remains optional
    - run_tests.py is ~11 s for the default 30 robots on an M4 Mac, measured,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
2026-11-10 ml: fix the curriculum gate and stop trusting best.zip
    Two fixes to the training pipeline. The shipped policy is unchanged: it still
    scores 180/180 and the weights in core/standup_policy.hpp are untouched.
    The curriculum gate. It ratcheted on a full success - caught first attempt and
    still balancing a second later - which sat near 12%, never reached UP_OK, and
    so left every worker pinned at PITCH_START. The curriculum had silently
    collapsed to "always train at 1.2 rad" for all 2 M steps. It now ratchets on a
    catchable handover (a success, or gentle >= GENTLE_OK, i.e. pitch rate
    <= ~6.7 rad/s): the thing the reward already pushes for, reached early, and
    harder as the start pitch grows, so it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
2026-11-11 sim: a parameterised staircase, and what the lidar can actually measure from it
    Groundwork for a learned stair descent. Two questions that turn out to have
    different answers, so they are measured separately.
    build_model.py --stairs [--rise --tread --steps --edge] generates a landing
    that ends at an edge, a staircase descending in +X, stairwell walls, and the
    120-ray lidar fan plus the sonar. The default floor is an infinite plane and
    cannot have an edge to fall off, so a staircase replaces it with a finite
    landing and one box per tread. robot_c.xml regenerates byte-identical.
    stairs_probe.py nods the body through 8-50 deg, projects every ray through
    MuJoCo's own site frames, and clusters t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
    [build_model.py, stairs_probe.py]
2026-11-11 core: a look-down nod, and why the safe version cannot see the step yet
    The stairs probe showed the sensing is fine but the lean is not: the balance
    law tops out at 13.7 deg of pitch where the geometry needs 29-38 deg to see
    over a step nose, and an open-loop torque pulse topples rather than leans.
    core: look_mode holds a pitch target with a PD on pitch alone, no position or
    speed terms - the same trick the dock lean uses, because keeping the position
    terms makes them fight the lean. It then slews the target back to upright
    before handing over; cutting straight back to the normal law at 34 deg does not
    recover, the position terms re-engage against a large pitch error and it goes
    over. bot_l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
    [botsim.py, controller.cpp, controller.hpp, sim_api.cpp, stairs_look.py]
2026-11-11 core: a nod that survives the CAN delay, and an RL setup for its timing
    The look-down nod worked on half the robots and I had not noticed, because
    sim/stairs_look.py only ever ran one. Over randomised robots it loses 7 in 10,
    and the split is perfectly clean: every failure is a robot that drew two
    control periods of CAN latency, every survivor drew one. At the full LQR pitch
    gains the nod's PD is a ~130 rad/s rate loop, and 4 ms of latency takes it
    unstable - the pitch rings, the wheels get pumped to 5 m/s and the 114 rad/s
    runaway guard cuts the motors. Half gains, exactly as the dock lean already
    uses, gives 10/10 at the same peak pitch. Two more fixes in the same block:
    the handover no lo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
    [botsim.py, controller.cpp, controller.hpp, sim_api.cpp, stairs_look.py]
2026-11-11 notes: the three traps the stair nod turned up, and a loop script for it
    CLAUDE.md gets the ones worth not repeating: a manoeuvre measured on one
    robot tells you nothing (the nod worked on the robot stairs_look.py happened
    to use and lost 7 in 10 over randomised ones, every failure a delay-2 robot);
    never hand a manoeuvre back to the balance law with v_ref_ = 0 while the robot
    is still moving; and --stairs landings are finite at both ends, so a script
    that reverses can drive off the back and have it read as a fall.
    ml/run_stairs_training.sh is the loop in order, scoring every candidate on
    ml/evaluate_stairs.py rather than trusting best.zip.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
2026-11-11 ml: the stair-measuring nod, and why RL did not beat the script
    The deliverable that works is the scripted one. On 30 held-out staircases
    (seeds 20000+, risers 80-170 mm, randomised robots) ml/stairs_baseline.py
    measures the first riser with success 0.37, and a grid search says 0.50 is the
    ceiling for ANY fixed standoff and depth - one nod carries no information about
    which riser it is facing, so that is the ceiling for the formulation, not a
    target to clear. Eleven PPO runs did not reach it. Three distinct failure
    modes, all of them mine rather than the optimiser's, all now written down next
    to the constants that caused them:
    * never look. At NO_NOD -2 against OFF_EDGE -10 refusing to no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
    [build_model.py]
2026-11-11 site: ten clips of the stair-measuring nod, successes and failures
    sim/stairs_video.py renders episodes through ml/stairs_env.py itself, so the
    controller, the LD19 noise, the attitude error and the estimator are the ones
    the evaluation numbers come from. The lidar fan is drawn, which is the whole
    story: you can watch the scan plane tip over and either catch the first tread
    or overfly it and land two steps down, which is the difference between a 2 mm
    reading and a 1016 mm one. The stairwell walls are made see-through for the
    camera only - alpha is a rendering property and MuJoCo's rangefinders do not
    consult it.
    Three things the clips made me fix in how this is reported:
    * the captions n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
    [build_stairs.py, stairs_video.py]
2026-11-11 core: an oscillating look, and what creeping up to the edge actually buys
    Asked for a slow approach and an oscillation from about 150 mm out. The
    oscillation is a good idea and is now in the controller; 150 mm is not, and the
    reason is geometric rather than anything to do with control.
    look_osc swings the pitch target through look_cycles of +-look_osc at look_hz,
    with the amplitude growing to look_osc_end across the swing. A flick is
    one-sided, so gravity acts forward for the whole nod and it costs 0.1-1.1 m of
    travel; a symmetric swing leans back for as long as it leans forward and
    travels almost nothing - 0.650 m of standoff became 0.638 m across six cycles.
    The growth matters because the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
    [botsim.py, controller.cpp, controller.hpp, sim_api.cpp, stairs_osc.py]
2026-11-11 site: two clips of the creep-and-oscillate, and the flick/swing comparison
    Twelve clips now. The two new ones are the answer to "creep in and oscillate
    from 15 cm", side by side: from 480 mm it reads the riser dead on, 100 mm
    against 100 off 277 returns with 378 mm of landing left; from 150 mm the same
    oscillation is perfectly stable and reads nothing at all, 0 returns on the
    first tread. Closer is worse, and the page says why - the step nose subtends a
    larger angle the nearer you are, so the pitch needed to clear it rises past
    what the swing can reach before it loses the robot.
    The seed search can now be asked for a CLEAN success rather than any success,
    which is what the 480 mm clip is: t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
    [build_stairs.py, stairs_video.py]
2026-11-11 stairs: the two looks side by side on the same staircase, ten times
    Ten pairs, flick left and swing right, on identical staircases: same riser,
    tread, start distance, robot and CAN latency, one recipe each. Unlike the
    twelve single clips these episodes are NOT selected - the seeds are the first
    ten of the evaluation set - so the tally is a fair sample. Flick 5/10, swing
    2/10, against 0.390 and 0.290 measured over 200 held-out staircases, a gap of
    2.1 sigma (the earlier 30-episode run read 0.37 vs 0.23, which was 1.2 sigma
    and settled nothing).
    What the pairs show that the averages do not: the swing's distinctive failure
    is no number at all, not a bad one. It stops close, pitches down, and e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
    [build_stairs.py, stairs_ab_video.py, stairs_video.py]
2026-11-11 stairs: reconstruct the step, refuse to guess, and look again if unsure
    Four measured pieces, all from the same proposal: stand still, look once,
    judge the look, and only then decide whether to go closer and look again.
    sim/stairs_windup.py - what the look costs from a standstill. A one-sided
    flick is a forward acceleration, so at 0.75 rad (the ~32 deg that can see a
    tread) it carries the robot +899 +- 264 mm towards the drop with nothing to
    cancel it. Reversing 0.9 s first - still from a standstill, still one forward
    look - reaches -0.47 m/s and the same flick costs +62 +- 86 mm, every robot
    upright. That is what makes "stop, settle, look once" affordable at an angle
    that actually sees som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
    [stairs_map.py, stairs_sonar.py, stairs_windup.py]
2026-11-12 stairs: the sonar sets the standoff, and the recipe nearly doubles its hit rate
    Wiring the sonar in, as a cone rather than the single ray the model carried,
    and using the one thing it can honestly report - the floor ahead has ended -
    to fix the distance to the drop from the world instead of from odometry.
    80 held-out staircases, seeds 20000+, the probe recipe either way:
    recipe ok answers riser err margin worst lost
    probe, odometry only 0.163 15/80 7.2+-7.0 268 164 0/80
    probe + sonar 15 deg 0.300 27/80 8.2+-7.3 209 75 0/80
    The gain is not accuracy, it is placement: the look only sees anything from
    inside a narrow band of s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
    [stairs_sonar.py]
2026-11-12 tof: either front sensor, and the geometry that decides which one can work
    The VL53L5CX as an alternative to the HC-SR04, in code, in the BOM, on the
    front panel, and measured against both existing recipes.
    Why it is mounted high, which is the opposite of what I said last time. A ray
    reaches the first tread only if it clears the nose and lands before the next,
    needing D < h*tread/rise, and the landing occludes everything below it short
    of the edge - so the vertical riser face is never visible from behind the edge
    at any angle, and the limit is the sensor's HEIGHT. At the sonar's 134 mm a
    170 mm riser is unreachable beyond 237 mm; at 194 mm, beyond 342 mm. Mounting
    a depth sensor low, as I s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
    [body_case.py, botsim.py, build_bom.py, config.h, controller.cpp, controller.hpp, erc.py, main.cpp]
2026-11-12 descend: the accelerometer catches the fall, and the honest verdict on steps
    Studying what it would take to go DOWN, as asked: can the array map several
    steps ahead (descend continuously), or must it take one, stop and re-measure?
    Mapping first, because it decides the shape. The occlusion condition for the
    k-th tread reduces to D <= h*tread/rise with no k in it - a staircase is
    self-similar, so a sensor that sees the first tread can geometrically see them
    all. What limits the map is resolution, not occlusion: 8 rows over 45 degrees
    resolves ~2 to 2.5 treads, the second to ~25-30 mm. Enough for a one-step
    lookahead; nowhere near enough to commit to a flight blind.
    So: one step at a time. Ex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
    [botsim.py, controller.cpp, controller.hpp, descend_video.py, stairs_descend.py]
2026-11-12 descend: commit to the step, and a flight of four
    The owner's strategy, built and measured: step, settle, back off to 75% of the
    tread (which is also where the array measures best, 250-300 mm), approach the
    next edge deliberately, repeat.
    The step itself is the part that changed. Reacting cannot work - rolling off a
    lip at walking pace produces no free fall at all, since the wheel stays on the
    corner the whole way down, so the accelerometer never sees anything while the
    velocity loop watches its support vanish and drives the wheels to -4.9 m/s.
    But the robot does not need to detect the edge: the array measured it to 13 mm
    before it moved. `step_mode` holds attitude across the lip with the s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
2026-11-12 viewer: put the zone array in the robot, and stop the sonar standing in for it
    The 3D viewer still showed an HC-SR04 in the nose. The VL53L5CX had been added to the
    CAD, the netlist and the firmware, but not to anything the owner actually looks at.
    - real_parts/export_viewer_real: the array is a part (c_tof), the sonar is labelled as
    the alternative, and the ESP32 says which module it is (DevKitC-1 N8R8).
    - site/index.html: the front aperture takes ONE sensor, so the viewer shows one - the
    array by default, with a "Front: zone array / sonar" toggle, an Inside-view label for
    it, and the front panel's description now mentions the 30 deg seat.
    - wiring.html / wiring_boards.html / print.h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
2026-11-12 site: the parts list, README and source bundle know about the zone array
    build_docs.py rebuilt after the CAD/BOM/ERC changes, so bom.html now carries the
    VL53L5CX row (Pololu #3417) and the J2T wiring row, and docs.html the front-sensor
    section and the J2T harness line.
    It needed two fixes to produce a publishable set at all:
    - The software zip had grown to 25 MB, and its base64 copy to 32 MB, past the 16 MB a
    published file may be. Cause: the copy swept in generated blobs - the viewer's part
    data, the built pages, site/files (which IS the downloads), ml/runs. Skip list plus a
    1 MB cap, since every file that size here is generated and rebuildable. Back to 4.1 MB.
    - source.json (what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
    [build_docs.py]
2026-11-12 wiring: one front sensor on the diagram too, not two boards side by side
    The owner read the wiring diagram as still having a sonar and no array - and that is
    what it showed: both boards drawn the same way, the HC-SR04 the bigger and more
    familiar of the two, nothing saying they are alternatives.
    - wiring_boards.html: the array is drawn first and titled "FRONT SENSOR, plug J2T",
    with its bus under it (SDA 42 / SCL 41, LPn 2, INT 47). The sonar moves below it,
    dimmed and dashed, titled "the ALTERNATIVE, plug J2", with "either / or: they share
    the front aperture. Fit one."
    - index.html, Wiring view: the harness of the sensor that is NOT selected is hidden,
    so the toggle now switches th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
2026-11-13 sim: the robot could not drive forward, and nothing said so
    BotSim.sense() built Inputs(...) without drop_m. ctypes zero-fills it, and 0.0
    does not mean "no reading": the C++ default is -1 = unknown, and 0.0 means the
    floor ends AT the wheels. check_drop() therefore returned a speed limit of 0,
    and controller.cpp applies that as a one-sided min - forward speed pinned to
    zero, reverse untouched, nothing faulted, state still BALANCE.
    So every test that asks only "did it stay upright" passed with the robot
    standing still. run_tests.py's cruise phase read -0.0 m/s against a committed
    1.114 and stop distance 0.0 against 0.637; the drive column of all three motor
    scripts scored 10/10 on a robot t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
    [botsim.py, check_structs.py, motor_compare.py, motor_isolate.py, wobble_compare.py]
2026-11-13 models: fetch the MF7015 STEP, and make the motor STEP path per-profile
    The L-7015's STEP, 2D drawing and parameter sheet are a plain public download
    from myactuator.com, unlike the MF6015's, which still has to come through the
    dealer's page - so fetch_models.sh takes it. The archive uses GBK filenames
    that unzip(1) refuses with "illegal byte sequence", hence the python extraction.
    Both land in models/bought/ and models/drawings/, which are gitignored.
    robot_paths.mf6015_step() becomes motor_step(profile) with a table saying where
    each motor's STEP comes from; mf6015_step() stays as an alias so assemble.py,
    real_assembly.py and rebuild.sh are untouched.
    Measured off the official STEP, agai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
2026-11-13 cad: one motor profile, and a body that fits the MF7015
    The motor interface was spelled out in seven places that were not linked:
    body_case's constants, wheel_adapter.py, motor_mount.py, the bare +29 in
    assemble.py, and the plug envelope copied into assemble.py, real_assembly.py
    and wiring.py. cad_src/case/motors.py is now the one definition, selected by
    ROBOT_MOTOR (mf6015 | mf7015) the way ROBOT_CASE and friends select paths.
    Every mechanical number is measured off the manufacturer's STEP and checked
    against its 2D drawing, not copied from a shop listing:
    MF6015 Ø58.0 x 34.0, Ø49x8 rear boss, 4 x M2.5 on 20x20, axial plug bay
    MF7015 Ø69.0 x 33.9, NO boss at all, 4 x M3 on 30x30,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
2026-11-14 cad: the shelf clears the motor's PLUG, and the harnesses follow the body
    wire_check.py under ROBOT_MOTOR=mf7015 was the only thing standing between
    the MF7015 body and a printed part nothing fits in. It found three classes of
    bug, all the same shape: a number that means "clear of X by k mm" written as
    an absolute coordinate, correct for exactly one body.
    1. wiring.py's routes. Every waypoint is hand-laid and every one of them is
    relative to something - the shelf top, the battery top, the top skin, the
    tray floor, the front panel, the back cover, the motor plug - and all of
    them were typed as absolute z and x. On the taller body six harnesses ran
    through the shelf, seven through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
    [body_case.py, motors.py, wiring.py]
2026-11-14 sim: one motor profile for the plant too, and the MF7015's verdict
    Phase 4: give the simulator the same motor record the CAD uses, then measure
    the MF7015 plant properly. The headline is that the swap breaks the stand-up,
    and not by being mistuned.
    The plant model lived in two files that each held their own copy of the motor:
    build_model.py (mass split, armature, stator geometry, ctrlrange) and
    botsim.py (KT, KE, R_LINE, I_MAX), all MF6015 literals. So the simulated motor
    could disagree with the CAD's and with the other file's, silently. Both now
    read sim/motor_profile.py, which loads cad_src/case/motors.py by path and is
    selected by ROBOT_MOTOR, exactly as the CAD is. Unset = mf6015 and re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
    [botsim.py, build_model.py, motor_profile.py, motors.py]
2026-11-14 sim: the MF7015 stand-up was never the motor's limit, it was mine
    Correction to 164a12b, which recorded the MF7015 23T as scoring 0/30 and 1/30
    on the stand-up and explained it as a physical speed ceiling. The explanation
    fitted the numbers and was wrong.
    sim/run_tests.py never calls bot_torque_limit - motor_compare.py,
    wobble_compare.py and motor_margin.py all do, it does not - so it uses
    whatever core/controller.hpp:107 holds. That run therefore gave the robot the
    new motor's mass penalty (+290 g, +44% pitch inertia) and its lower speed
    ceiling with NONE of its torque: 2.3 N.m, the MF6015's limit. The worst half
    of each motor, and a robot nobody would build.
    With torque_limit = 3.8f, the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
2026-11-14 core: the motor is a compile-time profile, and the runaway guard was cutting good kicks
    Phase 5. The headline is not the MF7015: the as-built robot has been aborting
    its own stand-up on its worst robots, and that is fixed here.
    THE GUARD. controller.cpp cut to FALLEN whenever the wheel speed relative to
    the body passed 95% of WHEEL_W_MAX, from LIFT all the way through BALANCE.
    Measured peak of that speed over 12 stand-ups, which is what the encoder and
    the back-EMF actually see:
    MF6015 ceiling 123.2 rad/s kick median 97.3 (79%) p90 105.7 max 117.2
    MF7015 ceiling 79.0 rad/s kick median 74.9 (95%) p90 79.1 max 81.2
    The guard sat at 0.95 x 120 = 114. The MF6015's kick peaks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
    [botsim.py, check_motor.py, controller.cpp, controller.hpp, motor.hpp, sim_api.cpp]
2026-11-14 sim: look_gain measured on delay-2 robots, and it carries over
    The last Phase 5 item. The plan said look_gain must be re-measured rather than
    carried over, because the nod runs inside BALANCE where the runaway guard
    applies and that threshold moves from 114 rad/s on the MF6015 to 75 on the
    MF7015. Measured, it carries over.
    sim/look_gain_sweep.py pins delay = 2 instead of sampling it. That is the
    whole point: BotSim.randomize draws one or two control periods of CAN latency
    with equal probability, and the delay-2 robots are the ones that decide this
    question, so a sweep over random seeds dilutes them. It reports the peak wheel
    speed relative to the body as a percentage of the guard, because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
2026-11-14 firmware: the encoder's field and its counts per turn are not the same number
    Phase 6, plus five stand-up clips of the MF7015 build for the artifact.
    THE ENCODER. lk_motor.cpp reads a 16-bit field out of the CAN reply and used
    ONE variable as both the modulus that field wraps at and the counts per
    mechanical turn. Equal for a 14/15/16-bit encoder, whose whole turn fits in
    the field. Not equal for a finer sensor sending its low 16 bits: an 18-bit
    count wraps the field four times a turn, the wrap detector reads that as
    "65536 counts per turn", and every angle, speed and odometry reading comes out
    4x too small with nothing faulted. That is the outcome the plan flagged as the
    one that cannot be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
    [can_probe.cpp, config.h, lk_motor.cpp, lk_motor.h, main.cpp, standup_video.py, test_lk_motor.cpp]
2026-11-14 firmware: the ESP32 image compiles here, and the 18-bit encoder is now measured, not argued
    PlatformIO and Espressif's QEMU fork were simply not installed; nothing about this machine
    prevented either. hil/setup_toolchain.sh installs both outside the repo and outside the project
    venv (which holds the pinned mujoco), and all six platformio.ini envs build with no warnings in
    project code: the robot image is 373 kB, 11.2% of flash, 6.6% of RAM.
    New env esp32s3_mf7015 builds the big-motor pair (-D FITTED_MOTOR=MOTOR_MF7015 -D BOT_MOTOR_MF7015),
    so main.cpp's static_assert that config.h and core/motor.hpp agree is now exercised by a real
    firmware build and not only by the host-test four-way compi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
    [build_docs.py, lkbus.py, run_hil.py]
2026-11-14 hil: the virtual motors come from the motor profile, and three identities must now agree
    hil/lkbus.py held its own copy of the MF6015's drive constants (IQ_FULL 16.5) - a third copy after
    sim/botsim.py and sim/build_model.py, both already fixed - so an mf7015 HIL run would have been
    measured against a drive that answers like the small motor. It reads sim/motor_profile.py now, i.e.
    cad_src/case/motors.py selected by ROBOT_MOTOR, like everything else.
    The encoder width comes from the same record, and the record says both motors are 18-bit sensors
    reporting through a 16-bit field (encoder_bits / reply_bits). So ENC_BITS now DEFAULTS to 18: the
    old default of 16 modelled a motor neither datashe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
    [botsim.py, design_lqr.py, lkbus.py, main.cpp, run_hil.py, sim_api.cpp]
2026-11-14 sim: the MF7015 stand-up never worked - the 30/30 was the mf6015 body with mf7015 motors
    Wiring hil/lkbus.py to the motor profile made a real MF7015 HIL run possible for the first time,
    and the first one failed: 0/6 stand-ups on the real firmware image in QEMU where the mf6015 image
    scores 6/6. The pure simulator agrees on the same plant and gains - 0/30 face-down, 2/30 back-down -
    so this is not a firmware-path artifact.
    Cause: sim/cad_mass.json is the CAD's output for ONE body, and ROBOT_MOTOR only switched the motor's
    own masses. Until cad_src/case/assemble.py had been re-run for the big motor, build_model.py was
    silently producing a hybrid - the mf6015 body with mf7015 motors - and its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
    [build_model.py]
